Dmlamanon/drone-hardware/docs/tooling-preflight-2026-08-17c.md

---
type: preflight
status: current
created: 2026-08-17
tags: [stevie, tooling]
---

# Tooling pre-flight — 2026-08-17 (batch 4)

## Working

| Tool | Version | Notes |
|---|---|---|
| gcc (host) | 16.1.0 MinGW-W64 | native tests |
| arm-none-eabi-gcc | 14.2.Rel1 | `make cross`, `make firmware` |
| kicad-cli | 10.0.5 | DRC/ERC, gerbers, exports, `--schematic-parity` |
| KiCad MCP | responds | swig backend |
| FreeCAD | 1.1.3 | headless `freecadcmd.exe`, non-standard install path |
| Python (system) | 3.14.6 | analysis scripts |
| Java | OpenJDK 25.0.4 | Freerouting host |

## NEW THIS BATCH — headless `pcbnew` Python is available, and it is the item-3 route

Item 3 asks for a zone-fill path that is **not** the MCP's, because that
one shattered both planes (In1.Cu 2 → 19 filled polygons, In2.Cu 1 → 22).

**KiCad ships its own Python interpreter with the `pcbnew` module bound:**

```
C:\Program Files\KiCad\10.0\bin\python.exe
>>> import pcbnew; pcbnew.GetBuildVersion()   ->  '10.0.5'
>>> hasattr(pcbnew, 'ZONE_FILLER')            ->  True
>>> hasattr(pcbnew, 'LoadBoard')              ->  True
```

Verified this session by actually loading the real board, not just by
importing the module: 65 footprints, and the zones enumerate correctly.

This is a genuinely different code path from the MCP's — it is KiCad's
own in-tree filler, invoked through KiCad's own interpreter, rather than
whatever the MCP server wraps. Whether it produces the same fragmentation
is the open question item 3 exists to answer, and the answer is measured
rather than assumed.

## A counting correction that matters for item 3

Earlier batches said this board has **3 zones**. It has **2 copper
pours**. The third `(zone ...)` block in the file is a **keepout inside a
footprint** (F.Cu, carries `(keepout ...)`, no net, no fill), which is
why `pcbnew`'s `board.Zones()` returns 2 and a naive regex over the file
returns 3.

The fragment-count baseline for item 3 is therefore, from the
git-committed copper:

| pour | layer | filled polygons |
|---|---|---|
| `/GND` | In1.Cu | **2** |
| `/3V3` | In2.Cu | **1** |

Anything above those numbers after a refill is fragmentation, and the
comparison must use the *same* measurement on both sides — the last batch
established that the hard way, when a "281 violations" baseline turned
out to be an artifact of running DRC on a board extracted without its
`.kicad_pro`.

## Ground station (item 7)

`engineering/drone-firmware/tools/ground-station/` exists with `gs.py`,
`telemetry_frame.py`, `params_cli.py`, `plot_session.py` and
`test_decoder.py`.

**Confirmed working this session by running it, not by noting it exists:**
the cross-validation that keeps the Python decoder byte-identical to the C
encoder is `tools/ground-station/test_decoder.py`. It compiles the real
`src/telemetry.c`, has it encode, and decodes in Python. Currently passing,
including the check `python encode() is byte-identical to C's`.

**It lives outside `test/`, so `make test` does not run it.** Item 7
requires extending it for any frame change, which means invoking it
explicitly (`python test_decoder.py` from that directory) in addition to
`make test`. If it ever reports "SKIPPED: no C compiler", the
cross-validation did not actually happen and the run proves nothing.

## Item 1's inputs both exist

- Board mounting holes: `MH1`–`MH4` in `bench_board.kicad_pcb`.
- Frame pattern: `FC_MOUNT = 30.5` in
  `mechanical/frame-v0/frame_v0.py`, and the exported
  `stevie-frame-v0-flats-petg.dxf`.

Item 1 requires extracting **both** from the actual files and asserting
they match — so the DXF must be parsed, not the script's constant read.
DXF export is confirmed working (97 KB written last batch).

## Carried forward

- **Freerouting 2.3.0** will not honour `(type power)` layer reservation
  and hung 16 minutes when forced. Unchanged.
- **FreeCAD rejects MSYS-style paths.** Every export path must be a
  native Windows path.
- **Do not use the MCP `refill_zones`.** Documented failure, item 3 says
  so explicitly.
- **`delete_trace` with both `net` and `position`** ignores the position
  and bulk-deletes the whole net. Pass one or the other.
- **`sync_schematic_to_board` strips the leading `/` from net names**,
  which disables this board's Power netclass. Re-check after any sync.

---

## BLOCKING-DIALOG HAZARD in headless pcbnew — found and fixed mid-batch

**`PCB_VIA::GetWidth()` and `SetWidth()` trip a wxWidgets debug assert on
KiCad 10** — *"called without a layer argument"*. Interactively that is a
modal dialog. **In an unattended batch it is a stall that waits forever
for a click nobody is there to give**, and the run looks hung rather than
broken. That is the failure mode that matters here: this batch runs with
nobody watching.

It fired from `scripts/viasite.py` while searching for a via site.

### The fix, in two layers

`scripts/kicad_safe.py` is now the shared preamble for **every** headless
pcbnew script in this repo, and it does both halves:

1. **`wx.DisableAsserts()` on import**, before any board is touched, so no
   script can forget it and no *future* assert of this class can stall a
   run either. Verified active (`asserts_disabled() -> True`) and the
   assert output is now zero lines where it was ten.
2. **Correct accessors**, because suppressing a dialog is not the same as
   calling the API right. KiCad 10 exposes layer-free
   `GetFrontWidth()` / `SetFrontWidth()`; `via_width()` and
   `set_via_width()` wrap them. Every via on this board is a plain
   through via, so front width *is* the width.

### Audit of every pcbnew call site in the repo

Done by grep rather than by memory, because the point is that none are
left:

| file | risky call | status |
|---|---|---|
| `viasite.py` | `GetWidth()` on a via | **was the one that fired** — now `via_width()` |
| `mh3_rework.py` | `SetWidth()` on a new via | now `set_via_width()` |
| `repath.py` | `GetWidth()`/`SetWidth()` | on `PCB_TRACK` only (guarded by an earlier `if via: continue`) — safe |
| `patternsearch.py` | `GetWidth()` | in the non-via branch — safe; `GetDrill()` on vias takes no layer and does not assert |
| `courtyards.py`, `fitpart.py`, `check_fc_pattern.py` | — | no via geometry |

**Standing rule for this project: any script that runs unattended imports
`kicad_safe` first.** A blocking dialog in a batch is not a nuisance, it
is an unbounded hang.

---

## Zone fill: the pcbnew route WORKS, and the MCP route still must not be used

Item 3 asked whether headless `pcbnew`'s `ZONE_FILLER` fragments the
planes the way the MCP's refill did. **It does not.**

Measured the same way on both sides — filled-polygon count read out of the
board file, which is the discipline that was missing when a "281
violations" baseline turned out to be a probe artifact:

| pour | git-stored | MCP refill (last batch) | **pcbnew ZONE_FILLER** |
|---|---|---|---|
| `/GND` on In1.Cu | 2 polygons | **19** | **2** |
| `/3V3` on In2.Cu | 1 polygon | **22** | **1** |

Coverage is unchanged too: 3291.2 → 3296.6 mm² on In1.Cu and
3089.6 → 3092.2 mm² on In2.Cu, the small increase being the new antipads
around the moved mounting holes and the new vias. So the fill is not just
un-fragmented, it is the *same plane*.

**And it fixed more than it was asked to.** DRC went **64 → 54**, which is
below the batch's starting baseline: every zone-related `clearance` and
`hole_clearance` violation cleared, including six that predate this batch.

`scripts/refill_zones.py` does the fill and prints the fragment count
before and after, so the question "did this shatter the planes" is
answered with a number rather than a hope. It exits non-zero if any pour
gains more than two polygons.

**The MCP `refill_zones` is still banned.** Nothing here rehabilitates it;
it shattered the planes on this same board and the ban stands.

### Why polygon count alone is not the proof — and what is

A reasonable objection to the table above: **a plane can be badly
fragmented while keeping the same filled-polygon count.** One polygon with
a huge void through the middle, joined by a thread of copper, counts as
one. So the count is necessary and not sufficient, and this is the exact
shape of error this project has made before.

Three independent measurements were taken, and the conclusion rests on
all three:

1. **Polygon count** — 2 and 1, matching the git-stored copper.
2. **Coverage area** — 3291.2 → 3296.6 mm² and 3089.6 → 3092.2 mm². A
   plane hollowed out by a void would lose area; these gained a little,
   which is the new antipads.
3. **`isolated_copper` from DRC — zero.** This is the one that actually
   speaks to connectivity: KiCad reports a fill island that connects to
   nothing on its net. The MCP's shattered fill produced **41** of these.
   The pcbnew fill produces **none**, and `via_dangling` is also **0**.

Point 3 is the load-bearing one. If a future refill keeps the count and
the area but splits a plane, `isolated_copper` is what will say so —
`scripts/refill_zones.py` checks the count, and **DRC has to be run
afterwards regardless.**
