Dmlamanon/drone-hardware/mechanical/frame-v0/stevie-frame-v0-petg.step

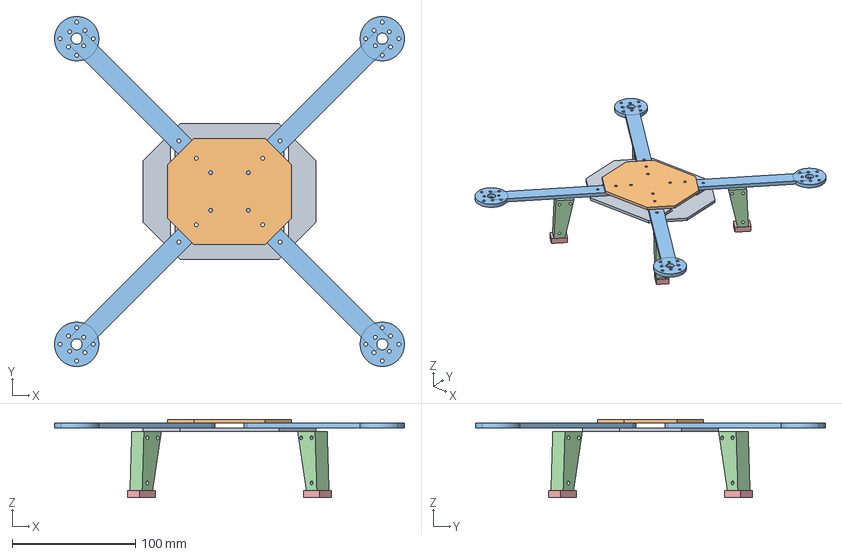
[picture p1: CAD file, 2026-08-18]
mechanical/frame-v0/stevie-frame-v0-petg.step
283.4 x 283.4 x 63.5 mm
bottom_plate
top_plate
arm_1
arm_2
arm_3
arm_4
leg_1
leg_2
leg_3
leg_4
foot_1
foot_2
foot_3
foot_4
