Dmlamanon/drone-hardware/mechanical/frame-v0/part-foot-1-petg.stl

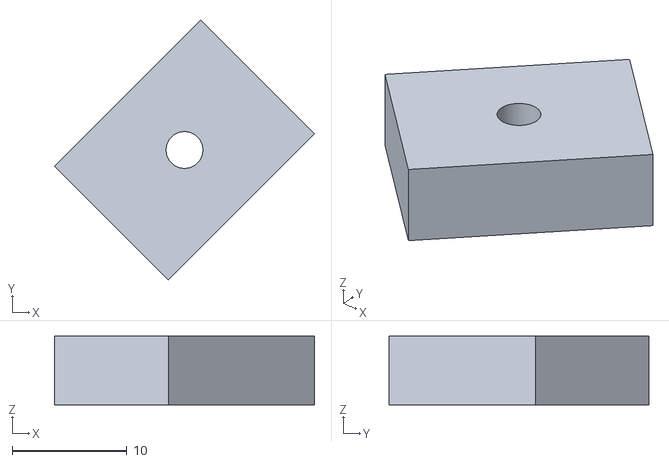
[picture p3: CAD file, 2026-08-17]
mechanical/frame-v0/part-foot-1-petg.stl
22.6 x 22.6 x 6.00
