Dmlamanon/drone-hardware/mechanical/frame-v0/part-leg-1-petg.stl

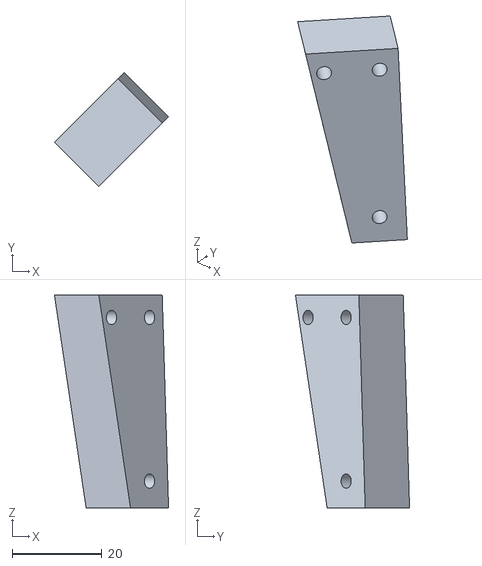
[picture p4: CAD file, 2026-08-17]
mechanical/frame-v0/part-leg-1-petg.stl
25.5 x 25.5 x 47.5
