Dmlamanon/drone-hardware/mechanical/frame-v0/stevie-frame-v0-flats-cf.dxf

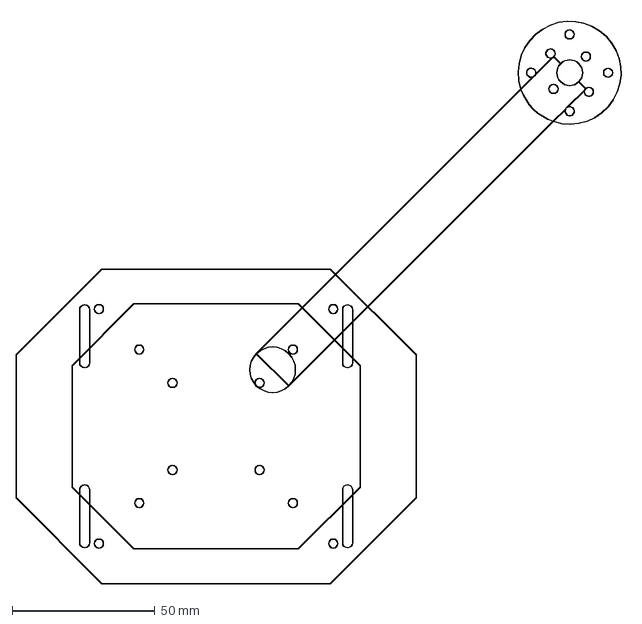
[picture p5: CAD file, 2026-08-17]
mechanical/frame-v0/stevie-frame-v0-flats-cf.dxf
213.4 x 198.4 mm
