Dmlamanon/drone-hardware/mechanical/frame-v0/stevie-frame-v0-flats-petg.dxf

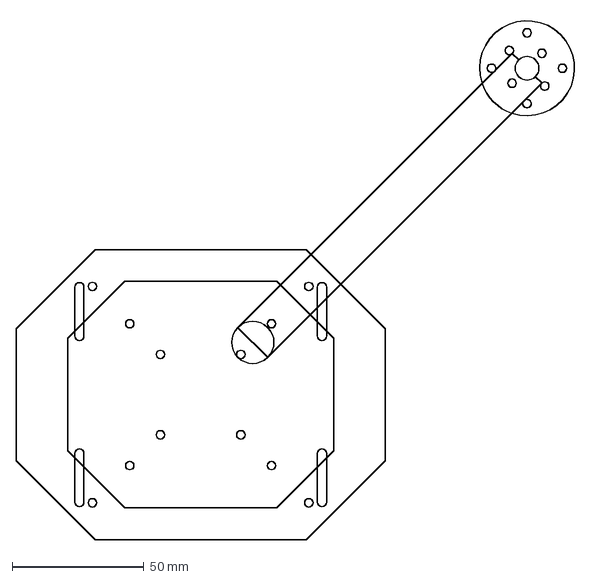
[picture p6: CAD file, 2026-08-17]
mechanical/frame-v0/stevie-frame-v0-flats-petg.dxf
213.4 x 198.4 mm
