Dmlamanon/drone-hardware/mechanical/frame-v0/part-bottom-plate-cf.stl

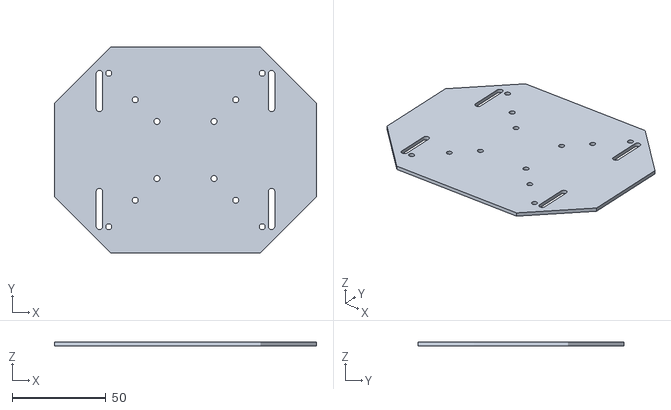
[picture p7: CAD file, 2026-08-17]
mechanical/frame-v0/part-bottom-plate-cf.stl
140.0 x 110.0 x 2.00
