Dmlamanon/drone-hardware/mechanical/frame-v0/part-bottom-plate-petg.stl

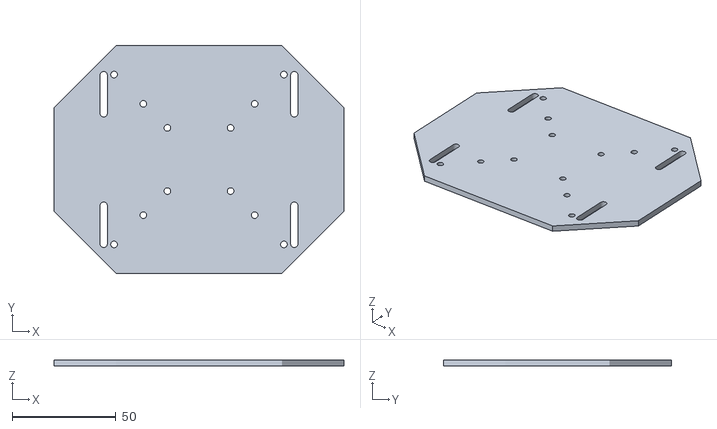
[picture p8: CAD file, 2026-08-17]
mechanical/frame-v0/part-bottom-plate-petg.stl
140.0 x 110.0 x 3.00
