Dmlamanon/drone-hardware/mechanical/frame-v0/part-arm-1-petg.stl

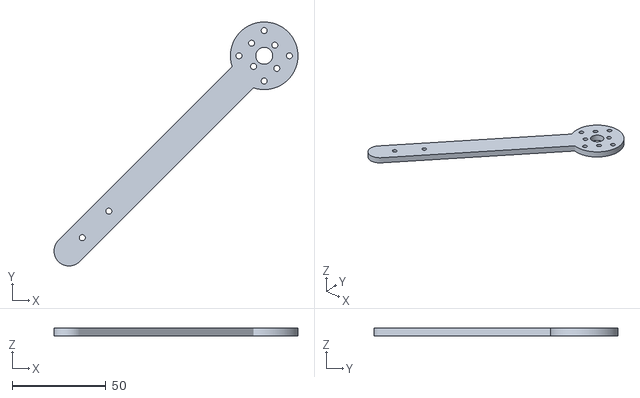
[picture p9: CAD file, 2026-08-17]
mechanical/frame-v0/part-arm-1-petg.stl
129.9 x 129.9 x 4.00
