Dmlamanon/drone-hardware/mechanical/frame-v0/part-arm-1-cf.stl

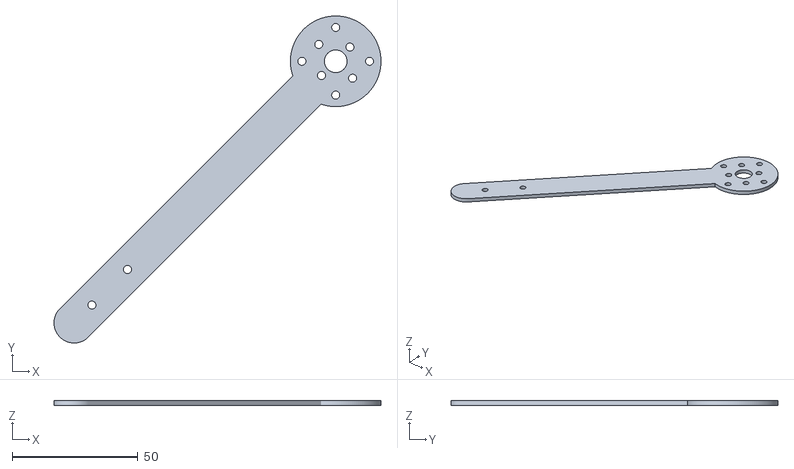
[picture p10: CAD file, 2026-08-17]
mechanical/frame-v0/part-arm-1-cf.stl
129.9 x 129.9 x 2.00
