Dmlamanon/drone-hardware/mechanical/frame-v0/part-top-plate-cf.stl

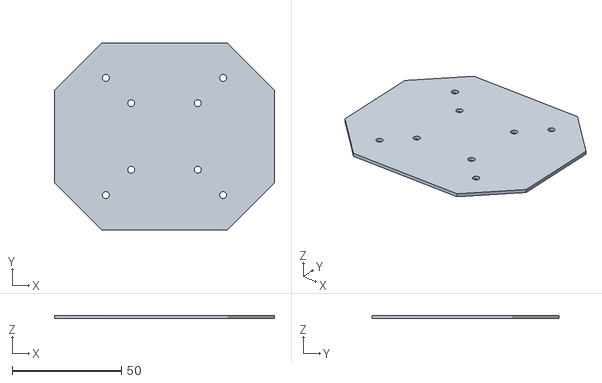
[picture p11: CAD file, 2026-08-17]
mechanical/frame-v0/part-top-plate-cf.stl
100.8 x 85.8 x 1.50
