Dmlamanon/drone-hardware/mechanical/frame-v0/part-top-plate-petg.stl

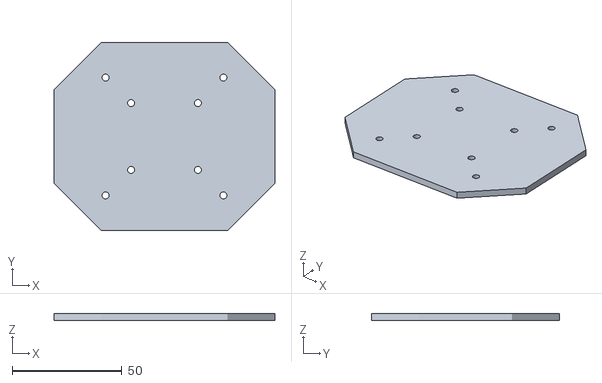
[picture p12: CAD file, 2026-08-17]
mechanical/frame-v0/part-top-plate-petg.stl
100.8 x 85.8 x 3.00
