Dmlamanon/drone-hardware/(list of files, cad)

Other CAD files:
mechanical/frame-v0/stevie-frame-v0-cf.stl
mechanical/frame-v0/stevie-frame-v0-petg.stl
