Dmlamanon/drone-hardware/mechanical/frame-v0/build-report-petg.txt

====================================================================
STEVIE frame v0 -- PETG variant
====================================================================
wheelbase (motor-motor diagonal) : 350.0 mm
adjacent motor spacing           : 247.49 mm  (= wheelbase / sqrt(2))
prop diameter                    : 228.6 mm
PROP TIP GAP                     : 18.89 mm  = 8.26 % of prop dia

The >=10 % rule needs one of:
  prop <= 225.0 mm (8.86 in) at this wheelbase, or
  wheelbase >= 355.6 mm with this prop

Frame geometry CANNOT improve this at a fixed wheelbase, and that is
worth stating as a derivation rather than an opinion:
  four motors sit on a circle of radius wheelbase/2. Adjacent tip gap
  is set by the SMALLEST adjacent chord. For a rectangle of half-width
  a and half-length b with 2*sqrt(a^2+b^2) = wheelbase, the adjacent
  spacings are 2a and 2b, so min(2a, 2b) is maximised at a = b --
  i.e. by the symmetric X this frame already is. A stretched or
  'dead-cat' layout makes one pair CLOSER, never further apart.
  Longer arms do not help either: they would increase the wheelbase,
  which is the fixed input.

arm length (root r=28 to pad edge) : 165.0 mm
plate 140 x 110 x 3.0 mm, arms 16 x 4.0 mm

bottom plate: 16 holes/slots cut, volume 39618 mm^3
top plate:    8 holes cut, volume 22954 mm^3
arm:          volume 12193 mm^3, 165.0 mm long
leg:          volume 10302 mm^3, 48 mm tall
foot:         volume 1464 mm^3 (the crash consumable)

geometry checks:
  every hole and slot is inside the plate OUTLINE, not just its bbox OK   all 28 clear
  battery bay fits within the plate long axis          OK   135.0 <= 140.0
  FC mount pattern clears the battery straps           OK   18.45 < 20.50 mm
  props do not overlap                                 OK   18.89 mm gap

PROP CLEARANCE: 8.26 % -- ACCEPTED 2026-08-17, not a failure.
  Precedent: the DJI Phantom 3 ships 9.4 in props on this same 350 mm
  class. Its adjacent spacing is the same 247.49 mm, so its tip gap is
  247.49 - 238.76 = 8.73 mm = 3.7 % of prop diameter -- less than HALF
  this frame's 8.3 %, on a flight-proven airframe built at scale.
  The >=10 % figure is a noise-and-efficiency guideline, not a limit.

  arm thickness meets the PETG minimum                 OK   4.0 mm
  plate thickness meets the PETG minimum               OK   3.0 mm
  motor pad clears the 16x19 cross                     OK   36.0 > 25.4
  motor pad clears the 19x19 square (the chosen X2814) OK   pad r 18.0 > 16.6
  the two patterns' holes do not merge into each other OK   9.62 mm apart
  arm root starts inside the plate                     OK   28.0 < 55.0
  the landing gear clears the slung battery            OK   53.5 mm ground clearance vs a 35.5 mm pack drop (18.0 mm of air, 12.0 required)
  the legs sit inboard of the motors                   OK   web reaches r=107.0, foot reaches r=110.0, motor at r=175.0
  the legs mount on the arm, not off the end of it     OK   top land spans r=85.0..105.0, arm spans 28.0..175.0
  the gear is not tippy (static tip-over angle)        OK   55.5 deg about the axis between two adjacent feet (>= 25 required)
  leg web thickness meets the printed-part minimum     OK   14.0 mm (printed in both builds -- see SHEET_PARTS)
  the landing gear is printed, not cut from the sheet  OK   sheet: bottom_plate, top_plate, arm_1 | printed: leg_1, foot_1
  symmetric X maximises the minimum adjacent spacing   OK   247.49 vs best stretched-X 247.49 mm

mass estimate (PETG sheet parts, rho = 1.27 g/cm^3;
               printed gear, rho = 1.27 g/cm^3):
  bottom plate        50.3 g
  top plate           29.2 g
  arms (x4)           61.9 g
  legs (x4)           52.3 g  (printed)
  feet (x4)            7.4 g  (printed)
  ---------------------------
  structure          201.2 g

  The AUW budget carries 469 g for 'frame'. This is STRUCTURE ONLY --
  Landing gear IS included from v0.1. Still missing: standoffs,
  fasteners, canopy and battery tray -- real mass, not modelled, so do
  NOT read 201 g as beating the budget.

SVG   -> D:\claude-obsidian\engineering\drone-hardware\mechanical\frame-v0\stevie-frame-v0-petg-plan.svg

STEP  -> D:\claude-obsidian\engineering\drone-hardware\mechanical\frame-v0\stevie-frame-v0-petg.step
STL   -> D:\claude-obsidian\engineering\drone-hardware\mechanical\frame-v0\stevie-frame-v0-petg.stl
STL   -> D:\claude-obsidian\engineering\drone-hardware\mechanical\frame-v0\part-bottom-plate-petg.stl
STL   -> D:\claude-obsidian\engineering\drone-hardware\mechanical\frame-v0\part-top-plate-petg.stl
STL   -> D:\claude-obsidian\engineering\drone-hardware\mechanical\frame-v0\part-arm-1-petg.stl
STL   -> D:\claude-obsidian\engineering\drone-hardware\mechanical\frame-v0\part-leg-1-petg.stl
STL   -> D:\claude-obsidian\engineering\drone-hardware\mechanical\frame-v0\part-foot-1-petg.stl
DXF   -> D:\claude-obsidian\engineering\drone-hardware\mechanical\frame-v0\stevie-frame-v0-flats-petg.dxf

RESULT: all geometry checks passed
