Dmlamanon/drone-hardware/(list of files, drawings)

Other design files:
bench_board/bench_board.dsn
bench_board/bench_board_constrained.dsn
