Dmlamanon/drone-hardware/bench_board/bench_board.kicad_pcb

## KiCad design bench_board/bench_board.kicad_pcb (2026-08-18)

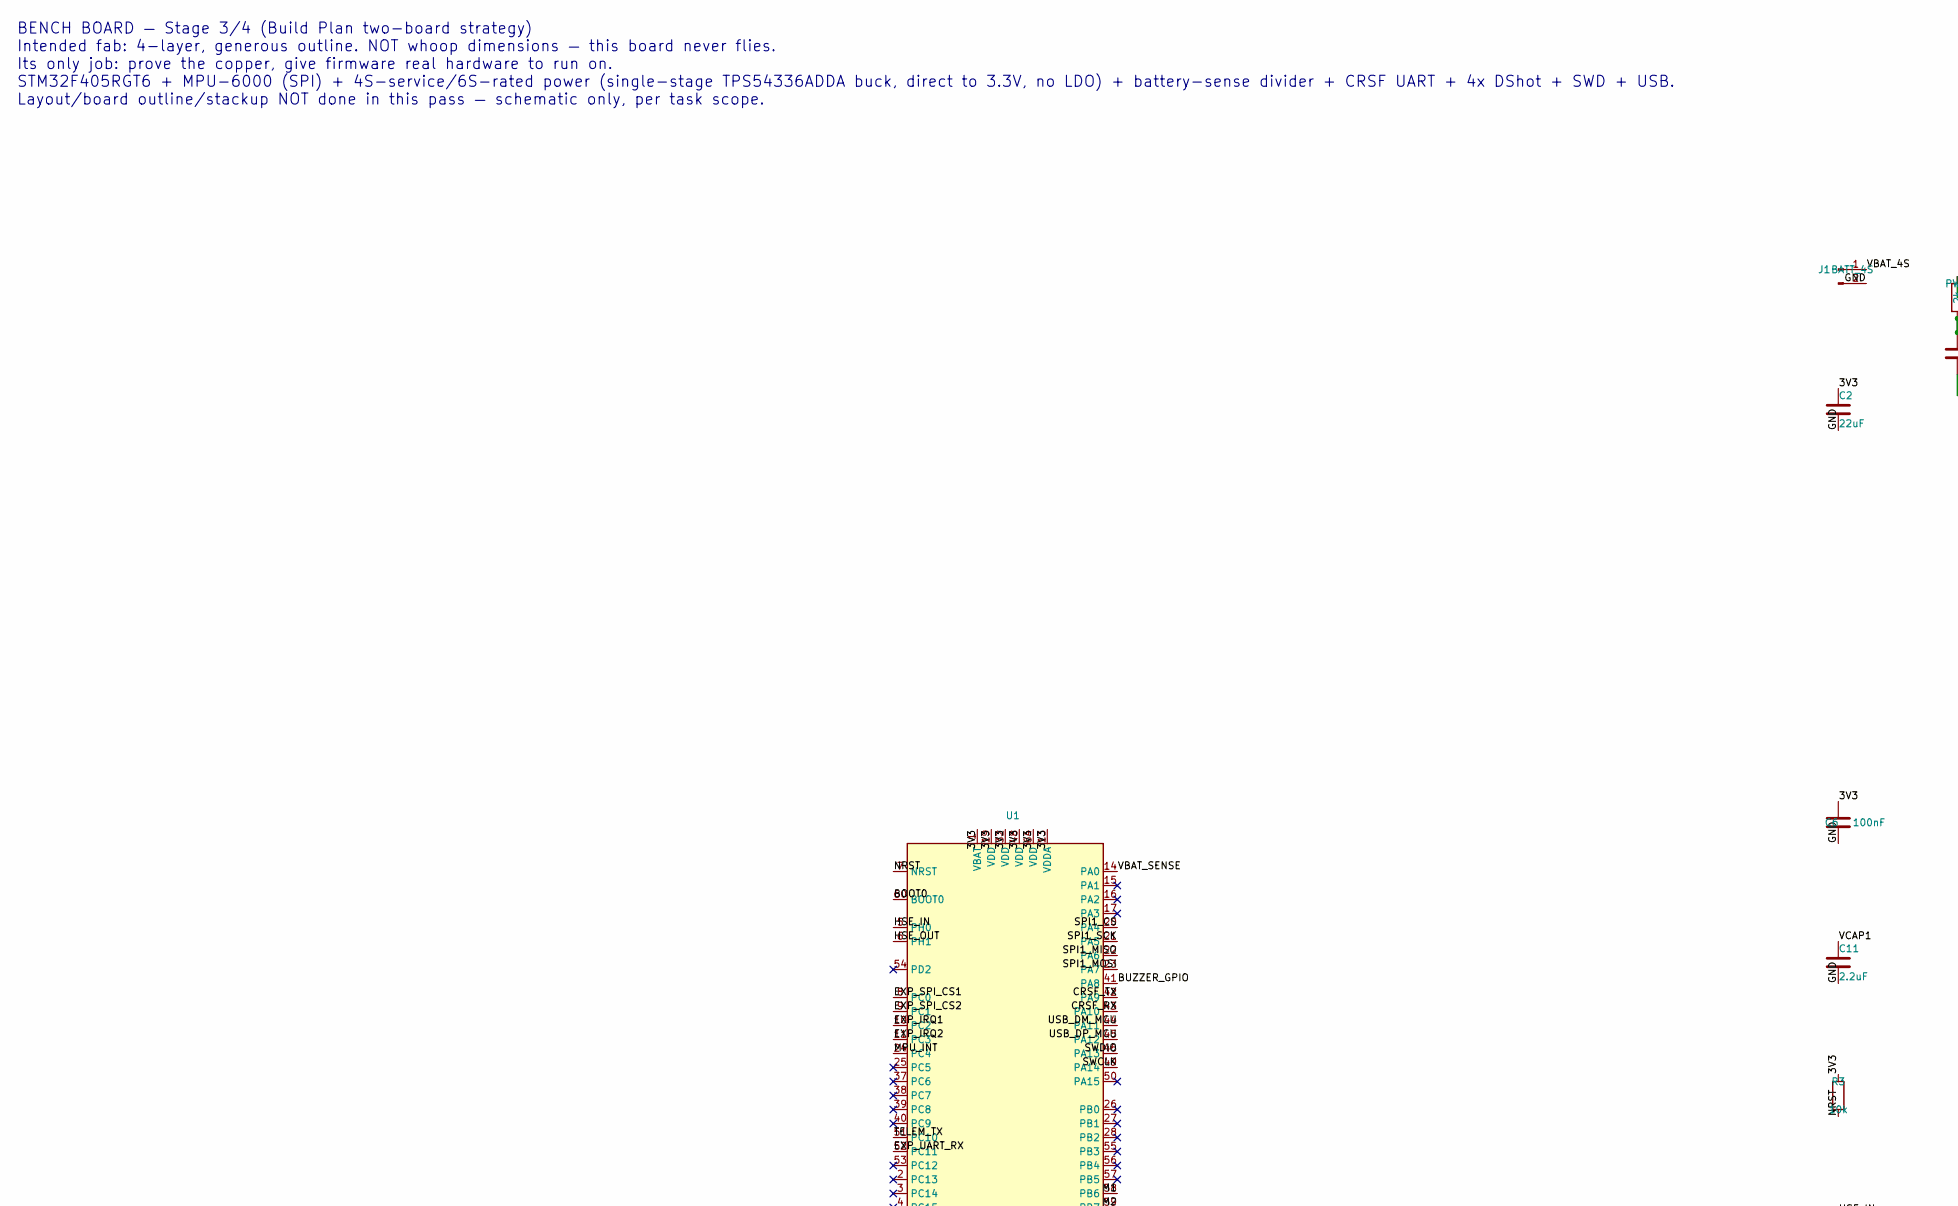
[picture p13: schematic bench_board.kicad_sch, part in row 1, column 1]

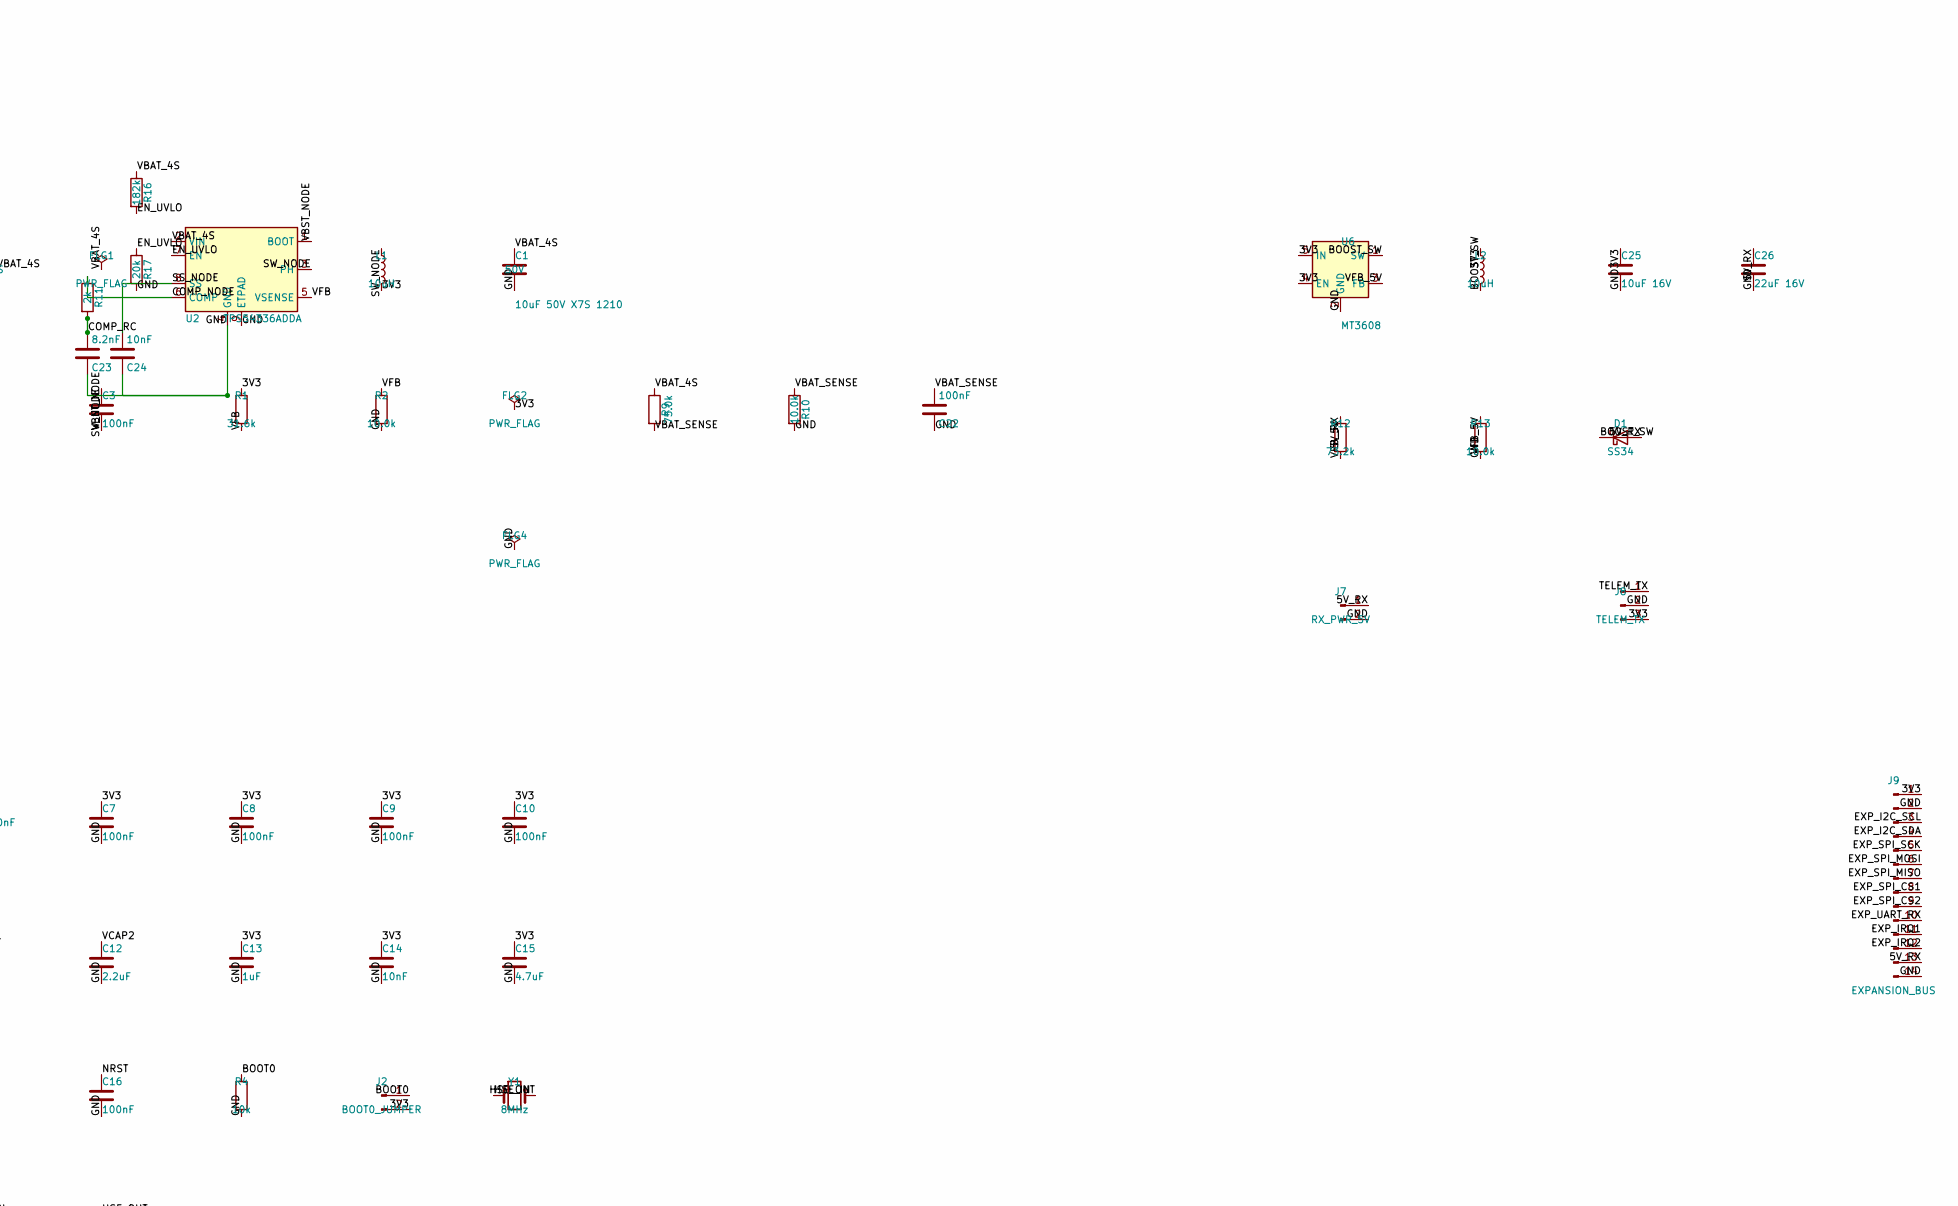
[picture p14: schematic bench_board.kicad_sch, part in row 1, column 2]

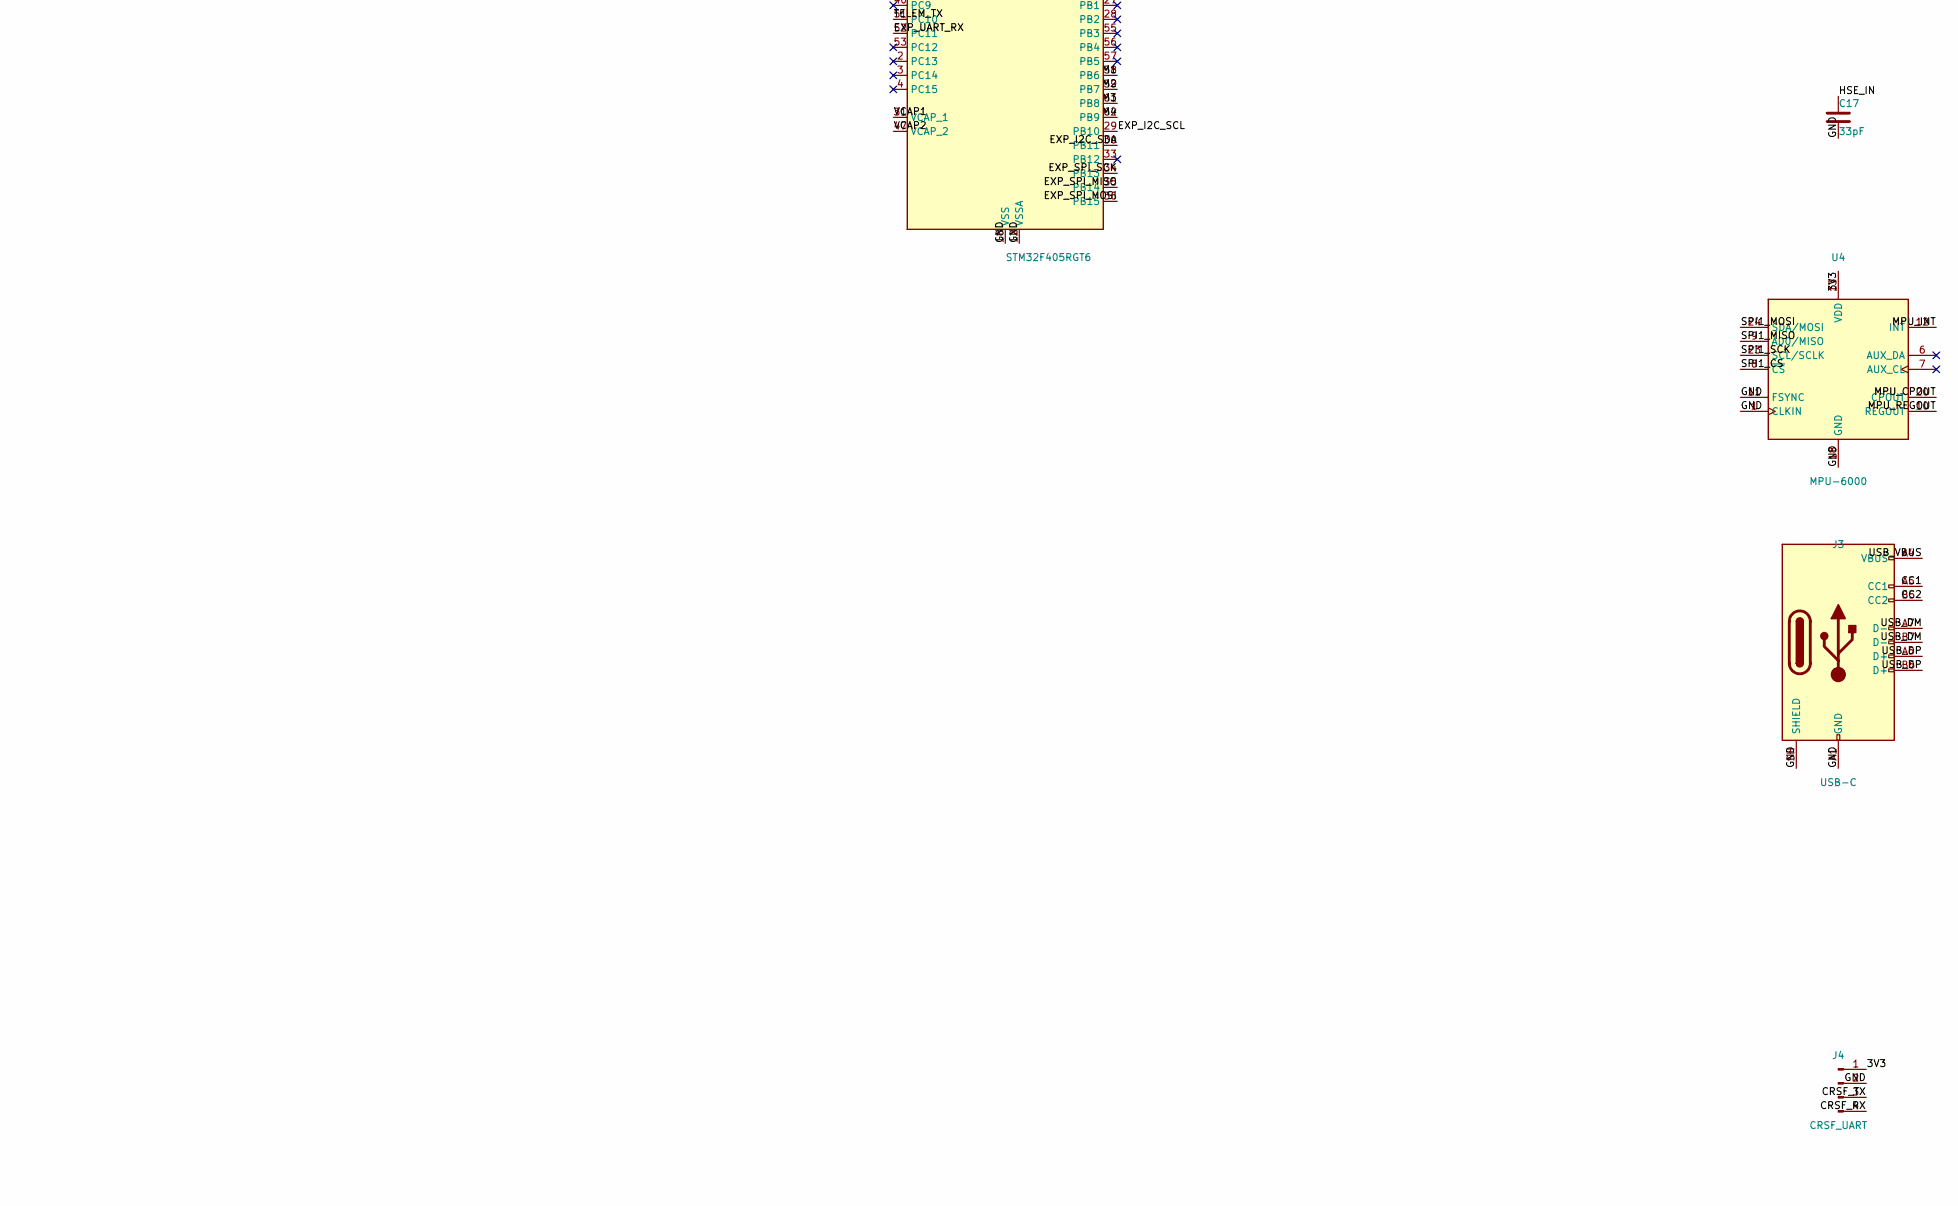
[picture p15: schematic bench_board.kicad_sch, part in row 2, column 1]

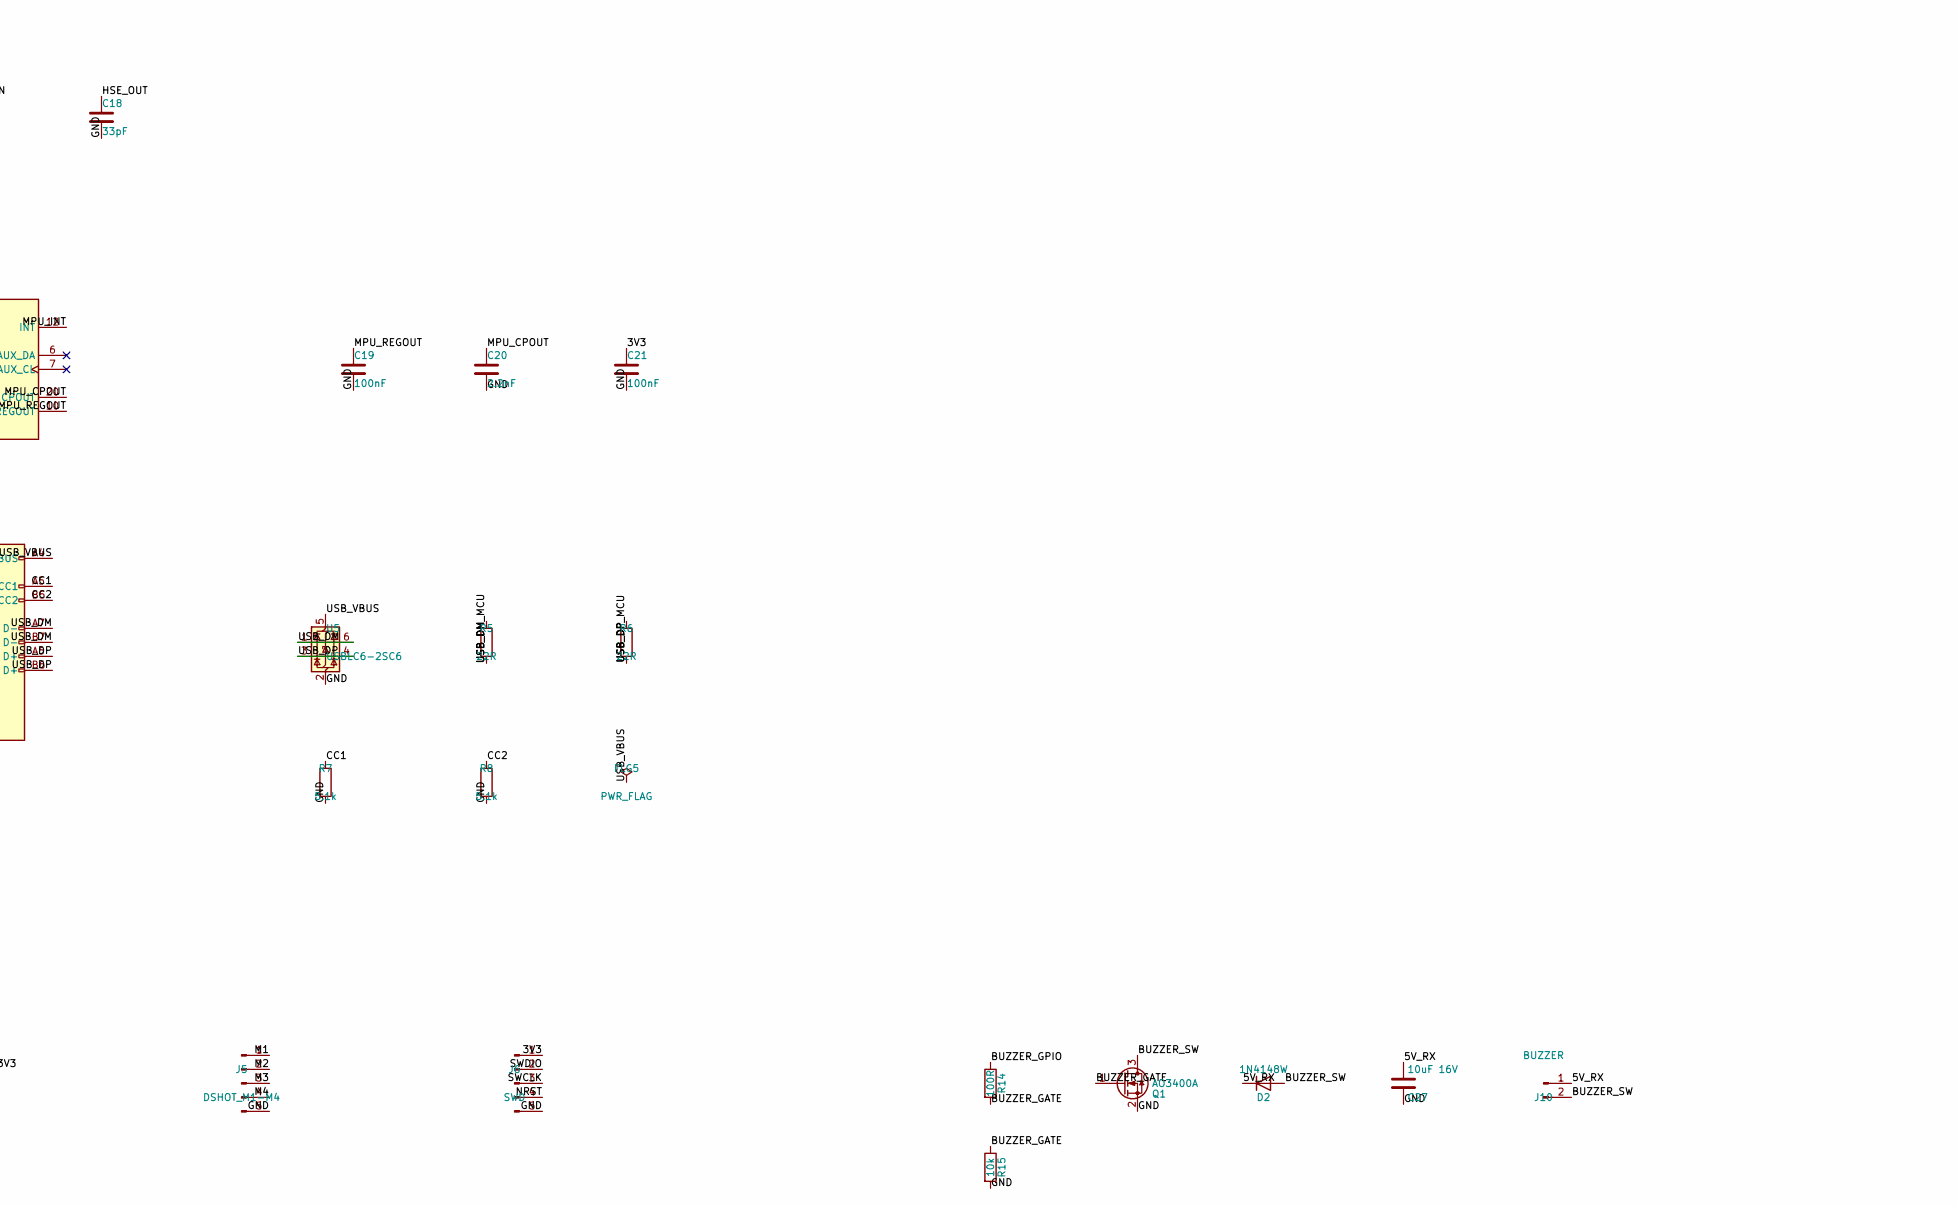
[picture p16: schematic bench_board.kicad_sch, part in row 2, column 2]

Parts:
C1: 10uF 50V X7S 1210; C_1210_3225Metric; Voltage 50V; MPN GRM32ER71H106KA12L
C2: 22uF; C_0805_2012Metric
C3, C6, C7, C8, C9, C10, C16, C19, C21, C22: 100nF; C_0402_1005Metric
C11, C12: 2.2uF; C_0603_1608Metric
C13: 1uF; C_0603_1608Metric
C14, C24: 10nF; C_0402_1005Metric
C15: 4.7uF; C_0805_2012Metric
C17, C18: 33pF; C_0402_1005Metric
C20: 2.2nF; C_0402_1005Metric
C23: 8.2nF; C_0402_1005Metric
C25, C27: 10uF 16V; C_0805_2012Metric
C26: 22uF 16V; C_0805_2012Metric
D1: SS34; D_SMA
D2: 1N4148W; D_SOD-123
FLG1, FLG2, FLG4, FLG5: PWR_FLAG
J1: BATT_4S; PinHeader_1x02_P2.54mm_Vertical
J2: BOOT0_JUMPER; PinHeader_1x02_P2.54mm_Vertical
J3: USB-C; USB_C_Receptacle_Amphenol_12401548E4-2A
J4: CRSF_UART; PinHeader_1x04_P2.54mm_Vertical
J5: DSHOT_M1-M4; PinHeader_1x05_P2.54mm_Vertical
J6: SWD; PinHeader_1x05_P2.54mm_Vertical
J7: RX_PWR_5V; PinHeader_1x02_P2.54mm_Vertical
J8: TELEM_TX; PinHeader_1x03_P2.54mm_Vertical
J9: EXPANSION_BUS; PinHeader_1x14_P2.54mm_Vertical
J10: BUZZER; PinHeader_1x02_P2.54mm_Vertical
L1, L2: 10uH; L_1210_3225Metric
Q1: AO3400A; SOT-23
R1: 31.6k; R_0402_1005Metric
R2, R10: 10.0k; R_0402_1005Metric
R3, R4, R15: 10k; R_0402_1005Metric
R5, R6: 22R; R_0402_1005Metric
R7, R8: 5.1k; R_0402_1005Metric
R9: 75.0k; R_0402_1005Metric
R11: 2k; R_0402_1005Metric
R12: 73.2k; R_0603_1608Metric
R13: 10.0k; R_0603_1608Metric
R14: 100R; R_0402_1005Metric
R16: 182k; R_0402_1005Metric
R17: 20k; R_0402_1005Metric
U1: STM32F405RGT6; LQFP-64_10x10mm_P0.5mm
U2: TPS54336ADDA; SOIC-8-1EP_3.9x4.9mm_P1.27mm_EP2.41x3.81mm
U4: MPU-6000; InvenSense_QFN-24_4x4mm_P0.5mm
U5: USBLC6-2SC6; SOT-23-6
U6: MT3608; SOT-23-6
Y1: 8MHz; Crystal_SMD_5032-2Pin_5.0x3.2mm; LCSC C115962

Connections:
/3V3: C2.1, C6.1, C7.1, C8.1, C9.1, C10.1, C13.1, C14.1, C15.1, C21.1, C25.1, FLG2.1, J2.2, J4.1, J6.1, J8.3, J9.1, L1.2, L2.1, R1.1, R3.1, U1.1 (VBAT), U1.13 (VDDA), U1.19 (VDD), U1.32 (VDD), U1.48 (VDD), U1.64 (VDD), U4.13 (VDD), U6.4 (EN), U6.5 (IN)
/5V_RX: C26.1, C27.1, D1.2 (A), D2.1 (K), J7.1, J9.13, J10.1, R12.1
/BOOST_SW: D1.1 (K), L2.2, U6.1 (SW)
/BOOT0: J2.1, R4.1, U1.60 (BOOT0)
/BUZZER_GATE: Q1.1 (G), R14.2, R15.1
/BUZZER_GPIO: R14.1, U1.41 (PA8)
/BUZZER_SW: D2.2 (A), J10.2, Q1.3 (D)
/CC1: J3.A5 (CC1), R7.1
/CC2: J3.B5 (CC2), R8.1
/COMP_NODE: R11.1, U2.6 (COMP)
/COMP_RC: C23.1, R11.2
/CRSF_RX: J4.4, U1.43 (PA10)
/CRSF_TX: J4.3, U1.42 (PA9)
/EN_UVLO: R16.2, R17.1, U2.7 (EN)
/EXP_I2C_SCL: J9.3, U1.29 (PB10)
/EXP_I2C_SDA: J9.4, U1.30 (PB11)
/EXP_IRQ1: J9.11, U1.10 (PC2)
/EXP_IRQ2: J9.12, U1.11 (PC3)
/EXP_SPI_CS1: J9.8, U1.8 (PC0)
/EXP_SPI_CS2: J9.9, U1.9 (PC1)
/EXP_SPI_MISO: J9.7, U1.35 (PB14)
/EXP_SPI_MOSI: J9.6, U1.36 (PB15)
/EXP_SPI_SCK: J9.5, U1.34 (PB13)
/EXP_UART_RX: J9.10, U1.52 (PC11)
/GND: C1.2, C2.2, C6.2, C7.2, C8.2, C9.2, C10.2, C11.2, C12.2, C13.2, C14.2, C15.2, C16.2, C17.2, C18.2, C19.2, C20.2, C21.2, C22.2, C23.2, C24.2, C25.2, C26.2, C27.2, FLG4.1, J1.2, J3.A1 (GND), J3.A12 (GND), J3.B1 (GND), J3.B12 (GND), J3.SH (SHIELD), J4.2, J5.5, J6.5, J7.2, J8.2, J9.2, J9.14, Q1.2 (S), R2.2, R4.2, R7.2, R8.2, R10.2, R13.2, R15.2, R17.2, U1.12 (VSSA), U1.18 (VSS), U1.63 (VSS), U2.4 (GND), U2.9 (ETPAD), U4.1 (CLKIN), U4.11 (FSYNC), U4.18 (GND), U5.2 (GND), U6.2 (GND)
/HSE_IN: C17.1, U1.5 (PH0), Y1.1
/HSE_OUT: C18.1, U1.6 (PH1), Y1.2
/M1: J5.1, U1.58 (PB6)
/M2: J5.2, U1.59 (PB7)
/M3: J5.3, U1.61 (PB8)
/M4: J5.4, U1.62 (PB9)
/MPU_CPOUT: C20.1, U4.20 (CPOUT)
/MPU_INT: U1.24 (PC4), U4.12 (INT)
/MPU_REGOUT: C19.1, U4.10 (REGOUT)
/NRST: C16.1, J6.4, R3.2, U1.7 (NRST)
/SPI1_CS: U1.20 (PA4), U4.8 (~CS)
/SPI1_MISO: U1.22 (PA6), U4.9 (AD0/MISO)
/SPI1_MOSI: U1.23 (PA7), U4.24 (SDA/MOSI)
/SPI1_SCK: U1.21 (PA5), U4.23 (SCL/SCLK)
/SS_NODE: C24.1, U2.8 (SS)
/SWCLK: J6.3, U1.49 (PA14)
/SWDIO: J6.2, U1.46 (PA13)
/SW_NODE: C3.1, L1.1, U2.3 (PH)
/TELEM_TX: J8.1, U1.51 (PC10)
/USB_DM: J3.A7 (D-), J3.B7 (D-), R5.1, U5.1 (I/O1), U5.6 (I/O1)
/USB_DM_MCU: R5.2, U1.44 (PA11)
/USB_DP: J3.A6 (D+), J3.B6 (D+), R6.1, U5.3 (I/O2), U5.4 (I/O2)
/USB_DP_MCU: R6.2, U1.45 (PA12)
/USB_VBUS: FLG5.1, J3.A4 (VBUS), J3.A9 (VBUS), J3.B4 (VBUS), J3.B9 (VBUS), U5.5 (VBUS)
/VBAT_4S: C1.1, FLG1.1, J1.1, R9.1, R16.1, U2.2 (VIN)
/VBAT_SENSE: C22.1, R9.2, R10.1, U1.14 (PA0)
/VBST_NODE: C3.2, U2.1 (BOOT)
/VCAP1: C11.1, U1.31 (VCAP_1)
/VCAP2: C12.1, U1.47 (VCAP_2)
/VFB: R1.2, R2.1, U2.5 (VSENSE)
/VFB_5V: R12.2, R13.1, U6.3 (FB)

Notes on the sheet:
BENCH BOARD — Stage 3/4 (Build Plan two-board strategy) Intended fab: 4-layer, generous outline. NOT whoop dimensions — this board never flies. Its only job: prove the copper, give firmware real hardware to run on. STM32F405RGT6 + MPU-6000 (SPI) + 4S-service/6S-rated power (single-stage TPS54336ADD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

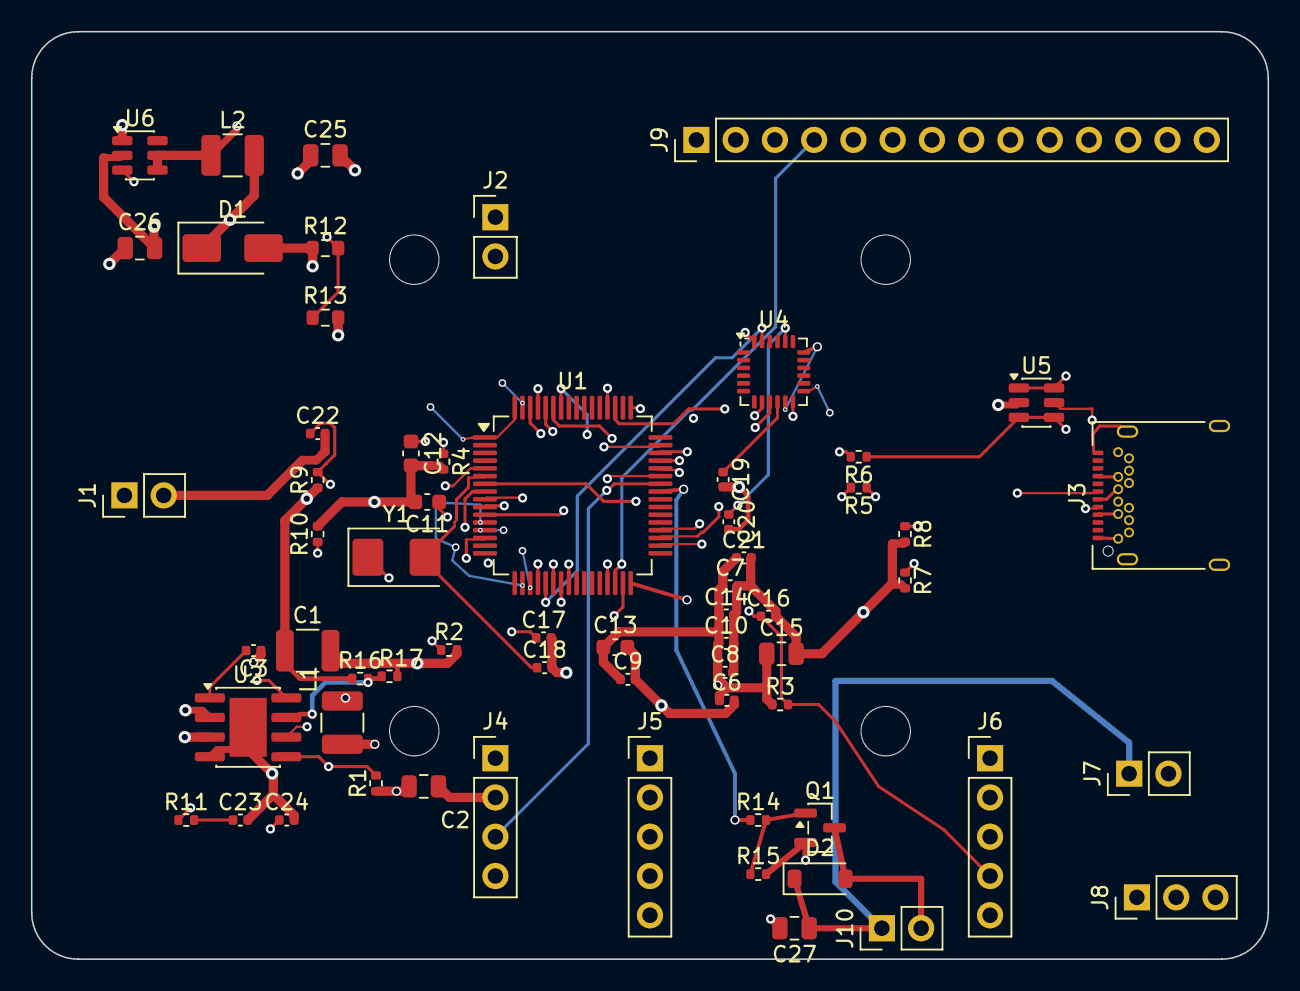
[picture p17: board bench_board.kicad_pcb from above]

Board: 4 copper layers, 80.0 x 60.0 mm, 67 parts (0 on the bottom side), 56 nets.

Other parts of the board:
MH1, MH2, MH3, MH4: MountingHole_3.2mm; MountingHole_3.2mm_M3
