Dmlamanon/drone-hardware/(commit log)

2026-08-16 Initial commit: bench board schematic (ERC clean)
    STM32F405RGT6 + MPU-6000 SPI + 2S power (buck->5V, LDO->3.3V) + CRSF
    UART + 4x DShot + SWD + USB, full bring-up circuit. 47 components,
    0 ERC errors/warnings. Schematic only, no layout yet.
    This repo had no version control until now -- first commit captures
    current state as the baseline.
    [bench_board.kicad_pcb, bench_board.kicad_sch]
2026-08-16 Power path analysis (SPICE blocked -- hand calculation instead, documented)
    ngspice isn't installed (no CLI, no winget package) and KiCad's bundled
    ngspice.dll is GUI-only (Eeschema's Simulate tab, no MCP/CLI path to
    drive it). Neither TPS563201 nor AMS1117-3.3 has a real SPICE model in
    KiCad's bundled symbol libraries either (grep -ic spice returns 0 on
    both). Documented both blockers rather than faking a simulation result.
    Did a hand-calculation analysis instead, against real datasheet
    parameters (TI product page for TPS563201, AMS datasheet for
    AMS1117-3.3), covering the same questions:
    Two real findings:
    - Buck duty-cycle margin fails at the low end of the board's own stated
    6.0-8.4V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
2026-08-16 Cross-check power design against known micro-FC failure modes
    For each power-relevant failure mode in .raw/micro-fc-failure-modes.md,
    states whether this board's design addresses it. Key result: the
    brownout/voltage-sag failure mode described in that research is the
    same finding as power-simulation-2026-08-16.md's buck duty-cycle
    margin issue, reached from the opposite direction -- one real risk,
    not two. Linear-regulator thermal failure is already addressed by the
    switching-buck-before-LDO architecture, confirmed quantitatively in
    the earlier analysis. ESC desync and a few others correctly ruled
    out as not applicable to this board's actual topology.
2026-08-16 Bench board PCB layout: 4-layer stackup, placement, ground plane -- not routed, not DRC-clean (documented)
    Synced 42 footprints from the finalized schematic. Added 2 inner
    copper layers (4-layer total); In1.Cu is a dedicated GND plane per
    the layout rules. 80x60mm outline -- generous, explicitly not whoop
    dimensions, this board never flies.
    Placement: force-directed auto-placement (suggest_placement) after
    manually anchoring the MCU, IMU, power section, USB, and headers.
    Verified 0 courtyard overlaps and 0 boundary violations before
    applying. IMU sits ~41mm from the switching regulator, satisfying the
    "don't place it near the switcher" rule -- computed from final
    coordinates, not assumed.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
    [bench_board.kicad_pcb]
2026-08-16 Rework power tree to single-stage buck (3.3V direct); add battery-sense divider
    Deletes the AMS1117 5V->3.3V LDO stage and its caps -- the 2-stage
    buck-then-LDO topology forced the buck to hold 5V from a 2S pack whose
    6.0V floor leaves only 1V of headroom (~83% duty cycle, at/past most buck
    ICs' practical limit). TPS563201 now regulates directly to 3.3V (feedback
    divider R1/R2 retargeted: 33.2k/10.0k, Vref=0.768V -> ~3.30V), which is
    what every load on this board (STM32F405, MPU-6000, DShot signal levels)
    actually wants. Duty cycle at 6.0V floor is now ~55%; at 8.4V ceiling
    ~39% -- comfortable across the whole battery range, both ends far from the
    TPS563201's ~90% max-duty limit.
    Inductor r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
    [bench_board.kicad_pcb, bench_board.kicad_sch]
2026-08-16 Re-sync PCB from reworked schematic; attempt Freerouting autoroute
    PCB was stale since the power-tree rework/battery-sense commit (a16eadb):
    sync_schematic_to_board only adds/updates footprints and net assignments,
    it does not delete footprints removed from the schematic or refresh Value
    text on ones that survived -- confirmed by inspection, not assumed.
    Manually closed both gaps: deleted U3/C4/C5 (the removed LDO stage) from
    the board, and pushed the schematic's new values onto the PCB (R1
    40.2k->33.2k, R2 7.32k->10.0k, L1 2.2uH->10uH, C3 2.2nF->100nF). Placed
    the 3 new battery-sense footprints (R9/R10/C22, synced in at the origin,
    stacked on top of each other) at (18.5, 26-32.5mm) -- clear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
    [bench_board.dsn, bench_board.kicad_pcb]
2026-08-17 Real ngspice verification of buck regulator (TPS54336ADDA), 4S+6S range
    Sources TI's own unencrypted PSpice average model for the part actually
    placed in the schematic (not the TPS54331DR documented in the 4S doc --
    a real discrepancy found this batch, see tooling-status.md). Verifies
    closed-loop startup, load-step, and regulation at 12.0V/14.8V/16.8V (4S
    range) and 25.2V (6S peak, never previously calculated for either
    regulator candidate). Recomputes output ripple at the part's real 340kHz
    switching frequency (the 4S doc used 570kHz, correct for the other part).
    Result: stable regulation and comfortable ripple/duty margin across the
    full 4S-6S range with a custom (non-TI-verified) compens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
2026-08-17 Resolve outstanding schematic WIP: fix stale 2S values, add missing compensation network, verify AC loop stability
    Item 1 review found the WIP wasn't just "uncommitted," it was incomplete
    and partly wrong -- read the actual diff before trusting it:
    - R1 was still the old 2S value (33.2k) despite the 4S doc already
    deriving 31.6k. Vout would have been 3.456V, not 3.3V. Fixed.
    - R9/R10 (battery-sense divider) were still 2S values (20.0k/10.0k,
    divide-by-3.0). Even the documented 4S-era fix (49.9k) doesn't have
    ADC headroom at true 6S peak (25.2V -> 4.2V on a 3.3V pin). Recomputed
    for real 6S safety: R9=75.0k (8.5x ratio, 2.965V at 6S peak). Firmware
    updated to match (see drone-firmw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
    [bench_board.kicad_sch]
2026-08-17 Archive superseded power docs to docs/superseded/, fix stale path references
    Same pattern as drone-firmware's inertia docs: three power analyses were
    competing in docs/ -- only power-spice-verification-2026-08-16.md is
    current. Moved the hand-calc analysis (power-simulation, done because no
    ngspice/SPICE models existed yet) and the 4S TPS54331DR verification
    (superseded by discovering the actually-placed part is a different IC,
    TPS54336ADDA) into docs/superseded/, each with a header block explaining
    what superseded it and why it's kept. Updated every remaining
    cross-reference (power-failure-modes-crosscheck, power-spice-verification,
    sim/tps54336_buck_verify.cir) to the new path. Left the tw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
2026-08-17 Fix stale schematic title-block text: 2S power description, three revisions out of date
    The schematic's own on-canvas summary text still described the original
    2S power tree (buck->5V, LDO->3.3V) despite the board having gone through
    the 4S rework (single-stage buck direct to 3.3V), the TPS54336ADDA
    part-swap discovery, and the 6S-safety battery-sense divider fix -- three
    revisions of real work the title block never reflected. Updated to
    describe the actual current design. ERC re-confirmed clean (0/0/0) after
    the edit. Re-exported wiki/_attachments/gallery/2026-08-16-schematic.pdf;
    the dashboard embed refreshes automatically (same filename).
    [bench_board.kicad_sch]
2026-08-17 Flag power-failure-modes-crosscheck.md as describing a superseded architecture
    Real finding from this batch's own new independent-review process: the
    prior commit (941cd9d) fixed this doc's path REFERENCES to the archived
    docs but left its substantive findings describing the original 2-stage
    2S design (TPS563201 buck -> AMS1117 LDO -> 3.3V) as if it were current
    -- directly contradicted by this same batch's own schematic title-block
    fix (503520b), which confirms the real board is single-stage
    (TPS54336ADDA direct to 3.3V, no LDO, no 5V rail at all). Added a warning
    header rather than moving it to docs/superseded/ (not one of the three
    doc-pairs this batch's item 4 was scoped to archive; a fu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
2026-08-17 Update magnetometer part choice to IST8310 (decided in drone-firmware item 13)
    Was left as an open "QMC5883L / IST8310-class" comparison. Now decided:
    IST8310, on the same real-KiCad-symbol-availability criterion the
    MPU-6000 IMU pick already used (IST8310 has one, QMC5883L doesn't). Full
    reasoning and the real driver landed in drone-firmware, not this repo --
    cross-referenced here since this is where the part-selection table lives.
2026-08-17 RX 5V rail (MT3608) + telemetry header into the schematic; ERC 0/0
    Item 1 of the board-finalization batch. Executes both lead decisions.
    RX POWER: MT3608 boost (LCSC C84817), 3.3V -> 5.0V, dedicated to the
    receiver. Verified rather than assumed, on the same criteria that picked
    the MPU-6000 and IST8310: native KiCad symbol exists
    (Regulator_Switching:MT3608), part is orderable at JLCPCB (Extended, not
    Basic -- setup fee applies), 162k in stock, $0.11 @1+.
    INPUT SIDE IS 3.3V, AND THE DATASHEET DECIDES IT: the MT3608's absolute
    maximum input is 24V, and this board is 6S-rated -- 6S peak is 25.2V.
    Battery-side input would exceed the part's rating by 1.2V at full charge.
    That is not a margin q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
    [bench_board.kicad_sch]
2026-08-17 Collision-avoidance provisioning: audit found 2 real conflicts, both fixed
    Item 2. Audited the expansion bus against the REAL pin budget and REAL
    datasheets rather than from memory, and it did not pass as-specified --
    two conflicts, both now resolved in the schematic.
    CONFLICT 1: PC10 was double-allocated. stm32f405-pin-assignment.md gives
    it to telemetry; expansion-bus-spec.md gives it to the bus as spare
    UART_TX. Item 1 of this batch made the collision concrete by wiring the
    telemetry header to it.
    Resolved by splitting USART3 by DIRECTION, which works because both users
    are unidirectional and opposite: PC10 TX to the ground station, PC11 RX
    from the forward lidar. Full-duplex hardware,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
    [bench_board.kicad_sch]
2026-08-17 Checkpoint: autoroute run + DRC that exposed a stale board (documented dirty)
    Autoroute completed (621 tracks, 86 vias, all 6 target nets, 4 attempts
    all converging on score 69501). Then DRC, run with --schematic-parity,
    came back 267 violations / 10 unconnected / 264 parity issues -- and the
    parity report explains the whole thing.
    THE BOARD WAS NEVER RE-SYNCED FROM THE SCHEMATIC. The PCB still carries
    the 2S-era power section:
    ref | board (stale) | schematic (current)
    ----+------------------------------+---------------------------
    U2 | TPS563201, SOT-23-6, 6 pads | TPS54336ADDA, SOIC-8-1EP
    J1 | BATT_2S | BATT_4S
    R1 | 33.2k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
    [bench_board.dsn, bench_board.kicad_pcb]
2026-08-17 Re-sync board to schematic, replace U2 properly, add In2 plane, re-route
    Fixes the stale-board defect from the previous commit. Full write-up in
    docs/stale-board-resync-2026-08-17.md.
    What changed:
    - U2 DELETED and re-placed from the library. Renaming the footprint
    field via edit_component was not enough and was actively harmful:
    it left the SOT-23-6's six lands under a SOIC-8 name, so the board
    was equally wrong but no longer advertised it. Correct geometry is
    13 pads (8 signal + thermal EP + 4 EP stitching).
    - J1/R1/R9/C1 values corrected to match the schematic. A scripted
    board-vs-schematic diff now shows zero value and zero footprint
    drift across all 55 parts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
    [bench_board.dsn, bench_board.kicad_pcb, bom_jlcpcb.csv]
2026-08-17 Item 6: fab package (gerbers, drill, CPL, BOM) -- marked NOT-READY-TO-ORDER
    fab/2026-08-17/ contains 11 gerber layers, Excellon PTH+NPTH drill with
    maps, a .gbrjob, pick-and-place for all 55 top-side parts, and a 38-line
    BOM with per-line sourcing notes.
    It is deliberately NOT marked ready to order. Two blockers, both stated
    at the top of the README rather than buried:
    1. 19 unconnected items, mostly U1's 3V3 supply pins (1,13,19,32,48,
    64) and GND pads with no via to the inner planes. An STM32 with
    floating VDD pins does not run. Needs manual routing in the KiCad
    UI; two scripted attempts are documented as failures.
    2. U2 (TPS54336ADDA, C1355769) showed as out of stock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
    [bench_board-B_Cu.gbr, bench_board-B_Mask.gbr, bench_board-B_Paste.gbr, bench_board-B_Silkscreen.gbr, bench_board-Edge_Cuts.gbr, bench_board-F_Cu.gbr, bench_board-F_Mask.gbr, bench_board-F_Paste.gbr]
2026-08-17 Add the mounting holes the board never had; re-route around them
    The board had NO mounting holes at all -- the only NPTH features were
    J3's two USB-C shell pegs. It could not have been bolted to anything.
    The standing placement rules call for 30.5x30.5mm and that had never
    been applied.
    Added 4 x M3 (3.2mm NPTH, 6mm pad) on the standard flight-controller
    pattern centred on the 80x60 board, at (24.75,14.75), (55.25,14.75),
    (24.75,45.25), (55.25,45.25). Positions were checked against every
    component first -- nearest neighbour is C2 at 3.6mm.
    Routing was cleared and redone so the router works around the holes
    rather than through them. Still ALL 51 nets: 509 tracks, 90 vias.
    The MCP wrote lib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
    [bench_board-B_Cu.gbr, bench_board-B_Mask.gbr, bench_board-B_Paste.gbr, bench_board-B_Silkscreen.gbr, bench_board-Edge_Cuts.gbr, bench_board-F_Cu.gbr, bench_board-F_Mask.gbr, bench_board-F_Paste.gbr]
2026-08-17 Correct four claims an independent review proved wrong
    The review checked this batch's hardware documents against the actual
    board file and found four statements that were not true. All are
    corrected inline, each saying what it replaced rather than being
    silently edited.
    1. "The inner layers are solid planes, which Freerouting detected and
    treated as such" -- FALSE. Freerouting's log says it configured them
    as power planes, then routed signals through them anyway: In1.Cu
    carries 97 segments across 24 nets, In2.Cu 90 across 24. Nets in the
    pours include SW_NODE (highest dV/dt node on the board), BOOST_SW,
    VBAT_4S (both inner layers), HSE_OUT, and VFB/VFB_5V/COMP_NODE.
    The G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
2026-08-17 Item 2: board blocker burn-down -- C23, Y1, C1, holes, net parity
    BLOCKER 4 CLEARED -- C23's net existed nowhere. The buck's compensation
    network is COMP_NODE -> R11 -> [nothing] -> C23 -> GND: the junction
    between R11 pin 2 and C23 pin 1 had no wire, so the TPS54336's control
    loop was not connected. Added the wire and a COMP_RC net label; ERC still
    0/0, and the net now appears on the board (52 nets, was 51). C23 is gone
    from the parity report.
    Y1 -- the board carried a 4-pin 3225 crystal footprint under a 2-PIN
    schematic symbol, which is why pads 3/4 were permanently unmatched in
    every sync. The only Basic-library 8MHz part (C115962) is a 2-pin
    SMD-5032. Delete-and-replaced to Crystal_SMD_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
    [bench_board.kicad_pcb, bench_board.kicad_sch, bench_board_constrained.dsn]
2026-08-17 Item 8: CFD/structural recommendation + material-independence rules
    docs/cfd-structural-recommendation-2026-08-17.md.
    Recommendation: DO NOT run CFD on the quadrotor; DO run it on the
    tiltrotor transition if that is ever built.
    Why not on the quad: the flow is rotor-dominated with no lifting
    surfaces, so it is unsteady at blade-pass frequency, needs moving
    reference frames or overset meshes, and is acutely sensitive to blade
    geometry that an off-the-shelf Gemfan prop does not publish. Weeks of
    work to produce a thrust curve the manufacturer already measured, more
    accurately, on a $60 thrust stand.
    What replaces it, in value order: vibration management (this project
    already has a concrete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
2026-08-17 Regenerate fab package from the fixed board; merge blockers 1+2
    All outputs regenerated from the board after C23 was reconnected, Y1 and
    C1 were re-footprinted, the mounting holes moved off nine components, and
    the net names normalised. Gerbers, drill, CPL (55 placeable parts, holes
    filtered out), plus the three SVGs and the 3D render.
    README restructured around the finding that blockers 1 and 2 are ONE
    problem, with the evidence inline: a fanout via at (27.90, 26.25) landed
    in a 5.5 x 0.8 mm ISLAND of 3V3 copper rather than the main pour, and
    (40,30) -- directly under the MCU -- is not covered by filled copper on
    either inner layer. You cannot via down to a plane that is not there, so
    the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
    [bench_board-B_Cu.gbr, bench_board-B_Mask.gbr, bench_board-B_Paste.gbr, bench_board-B_Silkscreen.gbr, bench_board-Edge_Cuts.gbr, bench_board-F_Cu.gbr, bench_board-F_Mask.gbr, bench_board-F_Paste.gbr]
2026-08-17 BOM: record this batch's verified sourcing
    Y1 moves Extended -> BASIC (C115962, SMD-5032-2P), the one removable
    setup fee the Extended audit found, and it came free with fixing a real
    defect: a 4-pin footprint under a 2-pin symbol.
    C1 respecified as 1210/50V X7R with the requirement stated as
    CAPACITANCE AT 16.8V BIAS. The earlier note confused voltage rating with
    bias derating -- a 35V 0805 at 16.8V also loses most of its capacitance,
    and 25V at 16.8V is not a rating violation at 1.49x margin. Bias
    derating is set by dielectric and case size, which is why the case grew.
    U2 stock resolved: 245 units, $1.0689/1, $0.8633/10+, verified against
    the LCSC part page rather than a search snippet.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
    [bom_jlcpcb.csv]
2026-08-17 Item 7: record tiltrotor provisioning against the real pin budget
    The lead ruling is provision-on-the-board, do-not-build-on-the-vehicle,
    so the question was whether the board can actually take it. Checked
    against the pin table rather than assumed.
    It can, cleanly. PC6-PC9 are TIM3_CH1-CH4 (AF2), also TIM8_CH1-CH4
    (AF3): four servo channels on ONE timer, so one timebase and four
    synchronised outputs, with no interaction with TIM4 which already drives
    DShot. Those four rows now record their timer capability instead of just
    saying "Free". Spare timer pins beyond them are listed too.
    An airspeed sensor -- mandatory for a tiltrotor, since the conversion
    corridor is defined in terms of airspeed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
2026-08-17 Fix the review's BLOCKER: the inner-layer fragmentation claim was wrong
    B1 (BLOCKER) -- I claimed the 15 unconnected pins were BLOCKED BEHIND
    fixing the inner layers, on the strength of a fanout via that "landed on
    a 5.5 x 0.8 mm isolated island of 3V3 copper". An independent review
    checked it against the committed board and it does not hold.
    THE EVIDENCE WAS AN ARTIFACT OF MY OWN PROBE. The via was placed at
    (27.90, 26.25), which is INSIDE the In1.Cu GND pour and OUTSIDE the
    In2.Cu 3V3 pour -- a 3V3 via dropped into the middle of the ground
    plane, where 3V3 copper does not reach. The zone filler then built a
    small 3V3 puddle around the via itself, and I read that puddle as proof
    of a shatt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
2026-08-17 Final DRC/ERC artifacts after the review fixes
    ERC 0 violations. DRC 46 / 15 / 88, unchanged by the doc corrections --
    the review's BLOCKER was about the INTERPRETATION of the board, not the
    board itself, so no copper moved.
    Claude-Session: https://claude.ai/code/session_013j3hUNiKQb8Wi66Tf5nVkP
2026-08-17 Item 0: tooling pre-flight -- FreeCAD route found, two item-6 inputs absent
    FreeCAD: there is NO freecad MCP (only kicad, github, gemini-cli and
    claude-in-chrome this session). Headless scripting IS the route and it
    works: FreeCAD 1.1.3 at a NON-STANDARD path,
    C:\Users\dmlam\AppData\Local\Programs\FreeCAD 1.1\bin\freecadcmd.exe --
    not under Program Files, which is why a naive check reports it missing.
    Verified by running real geometry rather than just launching it: box +
    cylinder, boolean cut (volume 590.575 mm3, correct), STEP and STL export
    both succeeded.
    One trap recorded because it aborts the whole script rather than
    warning: FreeCAD rejects MSYS-style paths. Import.export to
    "/tmp/x.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
2026-08-17 Item 1: two of the six safe fanout vias placed; unconnected 15 -> 13
    Placed ONE at a time with a full DRC after each, per the standing rule.
    No regressions: violations stayed at 46 through both.
    baseline 46 violations / 15 unconnected
    after U4.18 via 46 / 14
    after U1.32 via 46 / 13
    Both vias were sited with a checker that enforces the condition I skipped
    last batch: the location must be INSIDE the filled polygon of the plane
    carrying that pad's net, not merely near the pad. That is exactly the
    mistake that produced the bogus "isolated island" finding -- a 3V3 via
    placed inside the GND pour, where the filler built a puddle around it.
    U4.18 /GND -> via (50.827, 20.38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
    [bench_board.kicad_pcb]
2026-08-17 Item 2: per-net inner-layer cleanup -- target nets 28 -> 18 segments
    Approach that worked, and it is worth recording because it is the first
    time Freerouting has been usefully constrained on this board: delete the
    six EMI-critical nets ENTIRELY, then autoroute with the rest of the board
    left in place as fixed pre-routed wiring. Freerouting reported "78 SMD
    pins already connected" and touched only the deleted nets. 27 seconds.
    /HSE_OUT 5 -> 0 ** fully off the inner layers **
    /VBAT_4S 9 -> 5
    /HSE_IN 5 -> 4
    /SW_NODE 4 -> 4
    /VFB 3 -> 3
    /VFB_5V 2 -> 2
    total 28 -> 18 (-36%)
    DRC unchanged at 46 violations / 13 unconnected / 88 parity. No
    regression, no rule r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
    [bench_board.dsn, bench_board.kicad_pcb]
2026-08-17 Item 5 (hardware): buzzer on PA8 -- low-side MOSFET, placed and part-routed
    Q1 AO3400A low-side switch, R14 100R gate series, R15 10k pull-down, D2
    1N4148W flyback, C27 10uF local bulk, J10 2-pin header. PA8 chosen over
    several other free GPIOs because it is TIM1_CH1 and TIM1 is unused, so a
    passive buzzer with real tones stays possible with no board change. PA8's
    stale no-connect flag removed; ERC is 0/0.
    An F4 pin is rated 25 mA and a 12 mm buzzer draws 30-90 mA, so the FET is
    not optional. D2 is fitted even though a piezo buzzer would not need it --
    two cents to make the board buzzer-type-independent.
    THE PLACEMENT WAS WRONG FIRST TIME. Q1 and C27 landed on top of a 15.7 mm
    NRST track f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
    [bench_board.kicad_pcb, bench_board.kicad_sch]
2026-08-17 Item 6: parametric 350-class frame v0 in FreeCAD -- both material variants
    mechanical/frame-v0/frame_v0.py builds the whole frame from one PARAMETERS
    block and runs headless under freecadcmd (there is no FreeCAD MCP on this
    machine -- item 0 established that). Sandwich X quad: four flat arms bolted
    between a bottom and a top plate.
    MATERIAL INDEPENDENCE DRIVES THE SHAPE, not a note at the end. Because the
    frame must build as printed PETG-class OR as cut carbon plate, every
    structural part is a flat profile of constant thickness -- no draft, no
    ribs, no bosses, nothing only a printer can make. The same outline is
    printed or cut off the same DXF, and the DXF is exported. Thickness is the
    only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
    [part-arm-1-cf.stl, part-arm-1-petg.stl, part-bottom-plate-cf.stl, part-bottom-plate-petg.stl, part-top-plate-cf.stl, part-top-plate-petg.stl, stevie-frame-v0-cf.step, stevie-frame-v0-cf.stl]
2026-08-17 Item 6 follow-up: drill BOTH motor patterns -- the chosen motor did not fit
    Found while writing the thrust procedure against the parts list. Item 6
    specified a 2212-class pattern, which is a 16x19 cross. The motor this
    project has actually chosen is the iFlight XING X2814, whose pattern is a
    19x19 SQUARE. A square does not fit a cross, so the frame as first built
    would not have accepted the project's own motor.
    Both patterns are now drilled -- eight M3 on one pad, which is what
    commercial frames in this class do.
    The pad was 32 mm and the script's own geometry check REJECTED it: the
    square's corner holes sit at r=13.44, leaving under 1 mm of material
    outside the hole edge, which is a bolt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
    [part-arm-1-cf.stl, part-arm-1-petg.stl, stevie-frame-v0-cf.step, stevie-frame-v0-cf.stl, stevie-frame-v0-flats-cf.dxf, stevie-frame-v0-flats-petg.dxf, stevie-frame-v0-petg.step, stevie-frame-v0-petg.stl]
2026-08-17 Item 8 prep: fab package marked stale, fanout guide 13 -> 15 items
    The fab/2026-08-17 Gerbers predate items 1+2 (two fanout vias, inner-layer
    cleanup) and item 5 (the buzzer -- six components and their copper are
    missing from those files entirely). Bottleneck #5 in the last report said
    "upload engineering/drone-hardware/fab/2026-08-17/", which would now order
    the wrong board. Banner added at the top of that README.
    Also recorded there: before regenerating, the board's stored zone fill must
    be refilled in the KiCad UI, because it predates the buzzer footprints and
    has no antipads for J10's two through-holes.
    manual-fanout-guide updated 13 -> 15 remaining ratsnest items, with the two
    new one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
2026-08-17 Independent review: fix the frame's broken slots and make padclear real
    HIGH -- all four battery-strap slots broke out through the plate outline.
    Slot centres at x = +-56.5 put their outer ends at x+y = 98.75, and the
    octagon's chamfer is x+y = 95. So every exported STL, STEP and DXF had
    four OPEN NOTCHES, ~4.4 mm wide against a 3.5 mm slot -- a strap would
    have slid straight out. The review found it by reading the mesh.
    Slots moved to +-46, and the script now CHECKS it: every hole and slot
    corner is tested against the real outline, chamfers included, with 2 mm
    to spare. Verified in the rebuilt mesh -- the rounded tip arc is present
    and no vertex sits on the chamfer line. The check it repla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
    [part-bottom-plate-cf.stl, part-bottom-plate-petg.stl, stevie-frame-v0-cf.step, stevie-frame-v0-cf.stl, stevie-frame-v0-flats-cf.dxf, stevie-frame-v0-flats-petg.dxf, stevie-frame-v0-petg.step, stevie-frame-v0-petg.stl]
2026-08-17 Item 0: tooling pre-flight -- headless pcbnew Python found, the item-3 route
    KiCad ships its own interpreter at bin/python.exe with pcbnew bound
    (10.0.5, ZONE_FILLER present). Verified by loading the real board rather
    than by importing the module: 65 footprints, zones enumerate correctly.
    That is a genuinely different code path from the MCP refill that shattered
    the planes last batch.
    A counting correction that matters for item 3's measurement: this board
    has TWO copper pours, not three. The third (zone ...) block is a keepout
    INSIDE a footprint -- no net, no fill -- which is why pcbnew's Zones()
    returns 2 while a naive regex over the file returns 3. Baseline fragment
    counts from committed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
    [stevie-frame-v0-cf.step, stevie-frame-v0-petg.step]
2026-08-17 Item 1: the 30.5 mm mounting pattern is restored, and asserted from the files
    The holes went back to (24.75,14.75) (55.25,14.75) (24.75,45.25)
    (55.25,45.25) -- exactly where commit 4f49241 first put them, and exactly
    30.5 x 30.5 centred on the board. Commit 4cf2faf had scattered them to the
    corners to dodge components; per the lead ruling the components move
    instead, because the standard exists so hardware interchanges.
    WHAT WAS IN THE WAY, found by moving the holes first and letting DRC say:
    MH1 nothing -- the /BOOT0 tracks clear it by 2.27 mm
    MH2 /EXP_SPI_MISO on In1.Cu
    MH4 /NRST on F.Cu, /SWDIO and /SWCLK on In1.Cu (SWCLK ran through the
    hole centre -- 0.043 mm on the wr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
    [bench_board.kicad_pcb]
2026-08-17 Kill a blocking-dialog hazard in headless pcbnew (unattended-batch stall)
    PCB_VIA::GetWidth()/SetWidth() trip a wxWidgets debug assert on KiCad 10
    ("called without a layer argument"). Interactively that is a modal dialog;
    in an unattended batch it waits forever for a click nobody is there to
    give, and the run looks hung rather than broken. It fired from viasite.py
    while searching for a via site.
    scripts/kicad_safe.py is now the shared preamble for every headless pcbnew
    script here, and does both halves of the fix:
    1. wx.DisableAsserts() on import, before any board is touched, so no
    script can forget it and no FUTURE assert of this class can stall a
    run either. Verified: asserts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
2026-08-17 Item 2: the buzzer's own routing is closed; the rest is proven not scriptable
    BOTH buzzer nets are now routed and DRC-clean. Unconnected 15 -> 13.
    /BUZZER_GPIO -- the wire without which the buzzer is fitted and silent --
    runs U1 pad 41 to R14 on B.Cu, which had only 19 segments on it against
    F.Cu's 322. Two vias, sites chosen by a clearance search rather than by
    eye. The first attempt ran the B.Cu leg 0.21 mm from a /3V3 fanout via
    (DRC: shorting_items); the leg is now jogged to x=41.7 and clears it by
    0.27 mm.
    /5V_RX ties the buzzer's local island (D2/C27/J10) back to the boost rail
    at J7. Also B.Cu, and no vias at all -- both ends are through-hole pads,
    so the back layer reaches them dir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
    [bench_board.kicad_pcb]
2026-08-17 Item 3: headless pcbnew ZONE_FILLER refills the planes correctly
    The MCP refill shattered both inner planes last batch (In1.Cu 2 -> 19
    filled polygons, In2.Cu 1 -> 22) and that fill was discarded. KiCad's own
    in-tree filler, called through KiCad's own interpreter, does not:
    /GND on In1.Cu 2 -> 2 polygons
    /3V3 on In2.Cu 1 -> 1 polygon
    Measured the same way on both sides -- filled-polygon count read out of
    the board file -- because a comparison across two different measurements
    is what produced last batch's phantom "281 violations" baseline.
    Coverage confirms it is the SAME plane, not merely an un-fragmented one:
    3291.2 -> 3296.6 mm2 on In1.Cu and 3089.6 -> 3092.2 mm2 on In2.Cu, the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
    [bench_board.kicad_pcb]
2026-08-17 Item 4: fab package regenerated as fab/2026-08-17b/
    Fresh gerbers (11 layers), PTH/NPTH Excellon drills with maps, CPL, BOM,
    and a DRC+parity run, all from the board after items 1-3.
    THE COMPLETENESS CHECK THE ITEM ASKED FOR, done by diff rather than by
    eye: cpl_top.csv holds 61 rows against 61 placeable components on the
    board -- nothing missing, nothing extra. All six components the old
    package lacked (Q1, R14, R15, D2, C27, J10) are present.
    The four mounting holes are deliberately EXCLUDED from the CPL. kicad-cli
    includes them by default; telling an assembler to place an NPTH hole is
    how you get a support ticket. The old package excluded them too, so the
    55 -> 61 delta is exactly the s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
    [bench_board-B_Cu.gbr, bench_board-B_Mask.gbr, bench_board-B_Paste.gbr, bench_board-B_Silkscreen.gbr, bench_board-Edge_Cuts.gbr, bench_board-F_Cu.gbr, bench_board-F_Mask.gbr, bench_board-F_Paste.gbr]
2026-08-17 Item 6: frame v0.1 -- clearance ruling recorded, landing gear, fastener BOM
    ALL 16 GEOMETRY CHECKS NOW PASS, both variants.
    PROP CLEARANCE ACCEPTED. The lead ruled 8.3 % acceptable, so the script no
    longer reports it as a FAIL -- a standing failure that will never be fixed
    only teaches people to skim the report. It still prints the number in
    full; accepting a figure is not the same as hiding it.
    The precedent is recorded CHECKED rather than repeated: a Phantom 3 on
    this same 350 mm class has adjacent spacing 247.49 mm and 9.4 in props =
    238.76 mm, so its tip gap is 8.73 mm = 3.7 % -- less than half this
    frame's, flight-proven at scale. The arithmetic is in the build report so
    nobody has to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
    [part-foot-1-cf.stl, part-foot-1-petg.stl, part-leg-1-cf.stl, part-leg-1-petg.stl, stevie-frame-v0-cf.step, stevie-frame-v0-cf.stl, stevie-frame-v0-flats-cf.dxf, stevie-frame-v0-flats-petg.dxf]
2026-08-17 Item 8: final DRC/parity artifacts and the board render
    kicad-cli DRC with --schematic-parity, verbatim: 54 violations, 13
    unconnected, 93 parity issues. 54 is below the 64 this batch started at.
    Every rerouted net verified CONTINUOUS, not merely DRC-quiet: only /3V3
    and /GND appear in any unconnected item, so /SWCLK, /SWDIO, /NRST,
    /VBAT_4S, /SW_NODE, /EXP_SPI_MISO and all four buzzer nets are whole
    end to end. That matters because two reroutes this batch were done twice
    after a tool deleted segments it was not asked to.
    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
2026-08-17 Fanout guide: replace the estimate with the measured channel width
    The guide said the escape channel "is smaller than the smallest legal
    via". Measured off the board rather than estimated, it is 4.5x too narrow:
    U1's pads are 0.300 mm wide on a 0.500 mm pitch, so the gap is 0.200 mm,
    and the smallest legal via here needs 0.900 mm of channel (0.500 dia plus
    2 x 0.200 clearance).
    Worth numbers rather than an adjective: this is the sentence that justifies
    telling a human to do the work by hand, so it should be checkable.
    (First attempt at this edit used a "run to the next blank line" heuristic
    and deleted the whole surrounding section, including the 13-item list and
    the struck-through J3 corr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
2026-08-17 Record why the fragment-count check is not sufficient on its own
    A plane can be badly fragmented while keeping the same filled-polygon
    count -- one polygon with a void through it, joined by a thread, still
    counts as one. So the item-3 conclusion does not rest on that number
    alone, and the doc should not imply it does.
    Three independent measurements, all agreeing: polygon count (2 and 1,
    matching git), coverage area (unchanged to within 0.2 %), and -- the one
    that actually speaks to connectivity -- isolated_copper from DRC, which
    is ZERO where the MCP's shattered fill produced 41. via_dangling is 0 too.
    Recorded because the count is the cheap check and DRC is the real one, and
    someone readi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
2026-08-17 check_fc_pattern: fail if the DXF is older than the script that makes it
    The check reads the exported DXF rather than frame_v0.py's FC_MOUNT
    constant, deliberately -- the constant is what the frame intends, the DXF
    is what a cutter would actually make. But that reasoning only holds if
    the DXF is current. A stale export would let the check pass against an
    artifact nobody would build, which is the same failure mode as a checker
    that measures the wrong thing.
    Mutation-tested: touching frame_v0.py makes the check fail with the
    staleness in seconds, and regenerating the exports clears it.
    Claude-Session: https://claude.ai/code/session_013j3h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
    [stevie-frame-v0-petg.step]
2026-08-17 Correct the headline blocker's description: 13 connections, 15 pads, not '12 processor pins'
    Checked the DRC file instead of re-reading my own summary. The 13
    unconnected items span 15 pads -- 8 on U1, 3 on U4, 4 on J3's USB-C
    shield -- and two of the thirteen touch no chip at all. The claim that
    twelve were 'the processor's own power pins' folded the IMU and the
    connector shield into the MCU's count, and called connections 'pins'
    when a ratsnest item joins two pads.
    The conclusion is unchanged and still correct: the board cannot be
    ordered, because U1's supply pads are among them.
    docs/manual-fanout-guide-2026-08-17.md was right all along -- it lists
    the thirteen items rather than summari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
2026-08-17 Frame: derive the precedent comparison; stop tracking Python bytecode
    Two small things, both found by re-running the frame script and reading
    its output instead of trusting it.
    frame_v0.py printed a literal '%%' -- the string is not %-formatted, so
    the escape leaked into a line David reads. Alongside it, '8.3 %' was
    hardcoded in prose directly beneath a computed 8.26 %, and 'less than
    HALF' was an arithmetic claim written as a constant. All three are now
    derived from TIP_GAP_PCT and the Phantom 3 figures, so the sentence
    cannot drift away from the geometry: if the tip gap fell to 7 %, the
    line reads '1.9x less than' rather than continuing to claim HALF.
    Mutation-checked at 7.0 % and 5.0 %.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
    [stevie-frame-v0-petg.step]
2026-08-17 BLOCKER: the landing gear is 14 mm in the model and was published as 2-4 mm
    Found by independent review. build_leg() extrudes the web by LEG_W
    (14.0), not ARM_T -- so the leg is a 14 mm slab, identical in both
    builds. Three documents said otherwise, and the geometry check that
    should have caught it tested ARM_T, a variable the leg never uses:
    setting LEG_W to 0.5 mm left it printing 'OK 4.0 mm'.
    Worse, leg_1 and foot_1 were in stevie-frame-v0-flats-cf.dxf, which the
    README calls 'what makes the carbon option real'. Cutting leg_1 from 2 mm
    CF gives (2/14)^3 = 1/343 of the modelled sideways stiffness, and the
    M3x20 bolts -- sized 14 + 6 -- protrude 12 mm.
    RESOLUTION: the 14 mm leg is correct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
    [stevie-frame-v0-cf.step, stevie-frame-v0-flats-cf.dxf, stevie-frame-v0-flats-petg.dxf, stevie-frame-v0-petg.step]
2026-08-17 Fanout checker: true pad geometry, stub-vs-via, and a census of WHY
    Independent review flagged that the guide's stated REASON for zero legal
    fanout sites was wrong. Checking it turned up two more defects in the
    checker itself, and the reviewer's own diagnosis does not survive either.
    place_fanouts.py modelled every pad as a disc of radius hypot(w,h)/2. For
    U1's 1.55 x 0.30 mm LQFP pad that is a 0.789 mm disc against a true
    half-height of 0.15 mm -- inflating the obstacle by 0.639 mm, more than
    3x the 0.2 mm clearance rule. With true rotated-rectangle distance,
    U4.11 went from 0 legal sites to 29.
    I placed one and let DRC judge. It found a NEW clearance violation:
    'Track [/GND] length 1.600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
2026-08-17 Fanout guide: the escape channel is 1-22% of the reason, not the reason
    The guide told a human to 'drag the one or two signal traces that own the
    escape channel'. The census says that would burn a session: the VIA BODY
    accounts for 78-99% of rejected sites and the stub for 1-22%. The
    neighbourhood out to 3 mm is saturated, not pinched at one point.
    And for U1.1, U1.64 and U1.48 the /3V3 plane does not reach ANY candidate
    site, so no amount of trace-dragging finishes them -- the pour has to be
    extended first. That much of the review's finding stands, and it is the
    actionable half.
    The escape-channel arithmetic (0.200 mm available vs 0.900 mm needed)
    stays, because it is true and it is why a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
2026-08-17 check_fc_pattern: an M3 has to fit through the hole, not just line up
    From the independent review. The script checked that the four board
    drills matched EACH OTHER and never compared them to anything. Mutating
    all four to 2.0 mm left it printing
    ok: board holes are all the same drill size [2.0] mm
    ok: the board bolts to the frame (patterns are congruent)
    PASS: the board's mounting pattern matches the frame's FC standard
    and exiting 0, for a board no M3 bolt passes through. Matching each other
    is not the property that matters; matching the bolt is. Two checks added:
    the drill clears an M3 (3.2 mm), and it agrees with the frame's own hole
    diameter read from the DXF. Reproducing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
2026-08-17 Fanout guide: one 15-to-13 credited to two different causes; strike a third stale claim
    Measured rather than reasoned: DRC on the board as stored at each commit
    gives 6013565 (item 1) = 15 unconnected, 9442793 (item 2) = 13. So the
    drop is item 2's buzzer routing. The two fanout vias predate this batch
    and are worth 2 items, but they are not what moved this batch's count.
    Both misattributions corrected, with the measurement recorded.
    Also struck: 'Job A ... fixes J3's four through-hole shield pads for
    free'. That claim was disproved earlier in this same batch and the
    correction sits a few hundred lines above in the same file -- it just
    had not been carried down to the recommendation the rea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
2026-08-17 Item 0: batch-5 pre-flight -- freecadcmd confirmed, NO SWD tooling, CCM verified
    freecadcmd 1.1.3 confirmed headless (it has been driving frame_v0.py all
    day), so item 6 has its interpreter. Non-standard install path and the
    MSYS-path rejection both re-recorded.
    The finding that shapes item 1: there is NO SWD tooling on this machine
    and no probe attached. openocd, st-flash, st-info, STM32_Programmer_CLI,
    dfu-util, pyocd and JLinkExe are all absent -- not just off PATH, a
    directory sweep of both Program Files trees finds no install -- and
    Get-PnpDevice matching ST-Link/J-Link/CMSIS-DAP returns nothing.
    So item 1 ships tooling plus a dry-run mode, and the live-probe step is
    untestable here.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
2026-08-18 Item 5: checker-falsifiability audit, made executable and standing (B4)
    Eleven checks, each deliberately broken once to confirm it notices. All
    eleven are falsifiable; nothing had to be deleted.
    scripts/falsifiability_audit.py is the audit as an ARTIFACT rather than a
    prose table. It runs each check clean, applies one representative defect,
    runs it again, restores the file and VERIFIES the restore. It exits
    non-zero if any check survives its own mutation, which is what makes it
    usable as a standing wrap item instead of a one-time exercise. Added to
    the wrap checklist in next-task.md.
    Cases: frame leg thickness, frame ground clearance, sheet-only DXF,
    mounting pattern vs an M3, DXF stalenes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
2026-08-18 Item 6: full-assembly CAD, every component in position (B6)
    mechanical/assembly-v0/assembly_v0.py places frame, board, battery, ESC
    stack, four motors, prop discs, receiver, antenna keep-out, buzzer and the
    expansion access volume in one model. Seven checks, 54 interference pairs,
    STEP + STL + plan SVG, and a generated mass/CG/inertia doc.
    ZERO EDITS TO THE BOARD OR THE FAB PACKAGE, as required. The board enters
    read-only via mechanical/bench_board.step.
    PARAMETERS ARE IMPORTED, NOT COPIED -- and making that true meant
    extracting frame_params.py, the 163 lines of constants both frame_v0.py
    and the assembly now share. It is deliberately FreeCAD-free, so ordinary
    python can read it. The boar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
    [frame_params.py, frame_v0.py]
2026-08-18 wip: batch-5 review fixes (checkpoint before audit verification)
    [stevie-frame-v0-petg.step]
2026-08-18 Review fixes: the audit cleans up after itself, and covers the guards it missed
    H5: the audit left the repo dirty every run -- FreeCAD stamps a fresh
    timestamp into every STEP on regeneration, so each wrap produced a
    124,000-line spurious diff, training exactly the git-checkout habit that
    discards real regenerations. It also deleted a build report the wrapper
    could not recreate. The audit now snapshots every generated artifact
    (STEP/STL/DXF/SVG/report/doc) before anything runs and restores them
    byte-for-byte at the end, reporting what it disturbed. Verified: a full
    17-case run leaves git status clean.
    M1: the regeneration hook called freecadcmd directly and discarded the
    return value, viola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
2026-08-18 Assembly: the exploded render the brief asked for
    Item 6 required exploded AND assembled; only the assembled plan shipped.
    The elevation is the more useful of the two here -- the plan shows the
    footprint, but the STACK (pack under the plate, ESC on it, board on
    standoffs above) is what is hard to hold in your head from a parts list,
    and it is where the clearances are.
    run_freecad_check.py caught a syntax error in this very addition and
    refused the run, which is exactly the hazard it was built for four hours
    ago: bare freecadcmd would have exited 0 and left yesterday's exports
    looking current.
    Claude-Session: https://claude.ai/code/sessi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
2026-08-18 Item 0: batch-6 pre-flight -- kicad-cli 10.0.5, wx-assert preamble verified EXECUTING
    kicad-cli runs and reports 10.0.5 (the item-1 guard is built on it). The
    kicad_safe preamble is not just present in all 12 pcbnew-importing
    scripts -- importing it through KiCad's own interpreter confirms
    _ASSERTS_OFF is True at runtime, so no assert dialog can hang an
    unattended run.
    Standing constraints restated where the batch will trip over them: MCP
    refill still banned, refill_zones.py is the only refill path; the
    routing-attempt ban is lifted for THIS BATCH ONLY under item 1's guard
    contract; the current design rules' smallest legal via is 0.50/0.30 and
    any rule change toward JLCPCB's real capability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
2026-08-18 Item 1: board_guard.py -- the revert contract, proven before anything touches the board
    The guard runs the REAL kicad-cli DRC (--severity-all
    --schematic-parity), parses violations/unconnected/parity, and compares
    against a stored baseline. On ANY count increasing it reverts the board
    file to HEAD immediately and logs the failed attempt. Attempt 3 of the
    prior three (43 violations -> 235 -> 387) is exactly what happens
    without this: every edit judged by the model that proposed it.
    Baseline recorded verbatim: 54 violations / 13 unconnected / 93 parity,
    board sha256 502b23935fc5. Git tag batch6-board-baseline marks the
    revert target for the whole batch.
    PROVEN TO FAIL before first use: one t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
2026-08-18 Board: J3.A1 -> B12, 1.31 mm on F.Cu. Unconnected 13 -> 12 (guard-verified)
    The batch hypothesis (extend zone outlines) is refuted for all seven
    coverage pads -- both outlines are 4-vertex rectangles already covering
    every pad by 7-24 mm; the deficits are carved by clearance to protected
    copper, which no outline edit reaches. pour_reach.py records the per-pad
    evidence.
    What the probing DID find: DRC's own ratsnest arithmetic proves J3's PTH
    shield pads B1/B12 are ALREADY plane-connected (thermal spokes), and the
    SMD shields A1/A12 sit 1.31 mm from them across a clean F.Cu corridor.
    So A1 closes with one 0.2 mm surface trace to B12's annulus -- no via,
    no zone edit, no contact with the 214 p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
    [bench_board.kicad_pcb]
2026-08-18 Board rules: min_copper_edge_clearance 0.5 -> 0.3 (guard: 53/12/93, one baseline violation cleared)
    A DELIBERATE, CITED rule change, not a dodge. 0.5 was the KiCad default,
    not a fab limit: JLCPCB's published capability is 0.2 mm copper-to-NPTH
    and 0.3 mm trace-to-outline for routed edges. 0.3 keeps the stricter of
    the two with margin over their +-0.15 routing tolerance.
    Why now: J3.A12 is geometrically SEALED under the 0.5 rule. Its only
    corridors are bounded by a milled NPTH slot (0.95 mm tall after the
    connector's 90-degree rotation), A11's pad, the B-row annuli and a
    /USB_VBUS run -- the band between slot rim and A11 needs a centreline at
    y>=27.475 but A11 caps it at 27.373. Empty at 0.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
2026-08-18 Board: J3.A12 -> SH tab, threaded. Unconnected 12 -> 11 (guard: 53/11/93)
    A12 took all three strikes:
    1. The straight A12->B1 mirror trace: guard-reverted (56/11/93). The
    killer is an NPTH slot 0.95 mm TALL after the connector's rotation,
    with the milled-slot edge rule, not the round peg the passing A1
    side skirts.
    2. A dipped path through the computed legal band: guard-reverted
    (55/11/93). My band math used the 0.127 board minimum where the
    Power netclass demands 0.2 -- both new violations were exactly the
    A11 and B2 gaps at 0.175.
    3. This: a 3-segment thread UP and AROUND the slot to the connector's
    own shield tab (plane-connected through its spoke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
    [bench_board.kicad_pcb]
2026-08-18 Board rules: via minimums set to JLCPCB's published 4-layer capability
    min_via_diameter 0.45 -> 0.25, min_through_hole 0.30 -> 0.15,
    min_via_annular_width 0.10 -> 0.05. These were KiCad defaults, not fab
    limits: JLCPCB's 4-6 layer capability is 0.15 mm via hole / 0.25 mm via
    diameter, and the fab package targets exactly that process.
    Why it matters: the batch-4 impossibility proof was computed at the OLD
    minimum legal via (0.50/0.30, needing an r=0.45 clear disc). At 0.30/0.15
    the disc shrinks to r=0.35 and, decisively, a via fits AT AN SMD PAD TIP
    where neighbouring-pad clearance is exactly the 0.2 class value. Combined
    with B.Cu (19 segments on the whole board) as the escape layer, every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
2026-08-18 Board: U4.11 closed -- tangent 0.30/0.15 via + B.Cu leg to the existing GND via. 11 -> 10
    The pattern the rest of the batch now follows: a small via touching the
    pad (drill fully OUTSIDE the pad copper here, so no via-in-pad fee), a
    0.15 mm B.Cu leg across the nearly-empty bottom layer, landing on an
    already-plane-connected annulus at (50.83, 20.38). The via needs no fill
    under it -- B.Cu carries the connection -- which is the requirement that
    doomed the batch-4 search.
    Corridor verified against the full B.Cu map before applying: /MPU_INT
    via 0.26 clear, /MPU_CPOUT run 1.09 clear, /EXP_I2C_SDA diagonal does
    not overlap this x-range. Guard: 53/10/93, ratcheted.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
    [bench_board.kicad_pcb]
2026-08-18 Board: refill after the U4.11 via -- planes coherent (2/1 polys), guard 53/10/93 unchanged
    The standing sequence for every via from here on: addroute -> refill ->
    guard. U4.13's first attempt proved why: its two new 3V3 vias collided
    with the STORED In1 GND fill (clearance + hole_clearance at both
    positions), because the fill predates the vias. The refill regenerates
    the antipads; the guard then judges the real state.
    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
    [bench_board.kicad_pcb]
2026-08-18 Board: U4.13 closed -- stub + tip via + B.Cu leg + landing via. 10 -> 9 (guard 53/9/93)
    Attempt 2, with the refill in the loop. Attempt 1 connected (10 -> 9)
    but collided with the stored In1 GND fill at both new via positions --
    the exact class of error the guard exists to catch, and it did.
    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
    [bench_board.kicad_pcb]
2026-08-18 Board: U1.13 closed -- in-pad 0.30/0.15 via + B.Cu to a landing under the chip body. 9 -> 8
    First of the in-pad set: the via drill sits inside the 0.30 mm-wide LQFP
    pad, so this pad joins the epoxy-fill-and-cap list for the order sheet.
    The exact-0.200 clearance to the neighbouring pad passed DRC as computed.
    Guard 53/8/93, ratcheted.
    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
    [bench_board.kicad_pcb]
2026-08-18 Board: U1.19 closed -- in-pad via + B.Cu leg. 8 -> 7 (guard 53/7/93)
    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
    [bench_board.kicad_pcb]
2026-08-18 Board: U1.63 closed -- in-pad via + B.Cu leg. 7 -> 6 (guard 53/6/93)
    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
    [bench_board.kicad_pcb]
2026-08-18 Board: U1.12 closed on attempt 2 -- western B.Cu detour. 6 -> 5 (guard 53/5/93)
    Attempt 1's direct leg was blocked by MY OWN U1.13 route -- the two
    squeeze the same inter-pad corridor, and the guard caught the collision
    between the new GND leg and the day-old 3V3 leg (0.324 mm where 0.425 is
    needed). The detour runs south, west past the CS1/VCAP1/HSE_IN via
    minefield with verified berths (min 0.61 mm centre distance), north
    outside it, then into the same landing. 9.3 mm of B.Cu for one pin, and
    worth it.
    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
    [bench_board.kicad_pcb]
2026-08-18 Board: U1.1 closed -- 0.65 mm F.Cu stub through the /EXP_SPI_CS1 shadow, tip via, B.Cu leg. 5 -> 4 (guard 53/4/93)
    CS1 runs the whole left column on In1.Cu 0.665 mm from the pad centres,
    which is what killed every tip and in-pad site here: a through-via body
    cannot clear it. The site at lon 1.425 is past CS1's shadow; the stub
    that reaches it lives on F.Cu and legitimately flies OVER CS1 -- the
    checker itself had to be taught that (it was testing F.Cu stubs against
    inner-layer segments and rejecting every site on the column).
    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
    [bench_board.kicad_pcb]
2026-08-18 Board: U1.18 closed -- deep in-pad via (lon 0.15) + B.Cu dodge around VBAT_SENSE. 4 -> 3 (guard 53/3/93)
    The site search's floor was lon 0.30, where /VCAP1 on In2 blocks by
    48 um; the blocker FADES INWARD and lon 0.10-0.25 is legal. The search
    tool encoded an assumption the geometry did not share.
    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
    [bench_board.kicad_pcb]
2026-08-18 Board: U1.64 closed -- 1.6 mm interior diagonal to the now-connected pad 1. 3 -> 2 (guard 53/2/93)
    U1 has no interior keepout (U4 does -- its 'empty' interior turned out to
    be enforced by a rule area, which is what killed U4.1's third strike).
    Pad 64's own tip band is blocked on three layers at once (my new U1.63
    GND leg on B.Cu, /EXP_SPI_CS1 and /CRSF_RX on In1), but its corner
    neighbour pad 1 is 3V3 and now plane-connected, and the LQFP interior
    between their inner tips is genuinely empty.
    THE SCORE: 11 of 13 closed. The two remaining are each proven
    unclosable in scope three independent ways:
    U1.48 [3V3/VDD_3]: the /EXP_I2C_SDA B.Cu diagonal passes essentially
    through the pad positi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
    [bench_board.kicad_pcb]
2026-08-18 C23: 7.5nF -> 8.2nF (LCSC C107032) per ngspice loop-gain study; ERC 0, guard 53/2/93
    8.2nF raises phase margin at both corners (+1.2 deg at 14.8V and 25.2V)
    where 6.8nF lowers it; crossover unchanged within 0.5%. JLCPCB stocks no
    7.5nF MLCC. Study harness and results in sim/. Board+schematic value
    edited together; guard re-run PASS 53/2/93, ERC 0 violations.
    [bench_board.kicad_pcb, bench_board.kicad_sch]
2026-08-18 C1 resolved: GCM32EC71H106KA03 (LCSC C126612) verified at 16.8V bias
    Murata PIM bias curve read directly: -21.15% at 16.8V -> 7.89uF nominal,
    5.54uF at full worst-case stack; TPS54336A ripple-voltage and
    ripple-current requirements pass at every corner. BOM's example part
    GRM32ER71H106KA12L is EOL at Murata (NRND across the GRM32 50V 10uF
    line). New BOM row lands in fab/2026-08-17c.
2026-08-18 J3 resolved: no JLCPCB-stocked USB-C is pad-compatible -- hand-fit the genuine Amphenol
    Measured every candidate family against the board's actual pad table via
    EasyEDA footprint pulls: QCHT/HRO hybrids have B-row cols 0.10mm off and
    rear shield legs 1.6mm short of the board slots (cannot seat); stocked
    Amphenol siblings (C464604, C5119948) are dual-SMT B-row variants whose
    feet land across the open staggered B holes. Exact 12401548E4 not in
    catalog. J3 goes on the order sheet as hand-fit from Digi-Key/Mouser;
    B-row+shield-only soldering yields a working USB 2.0 port.
2026-08-18 Item 5: fab package 2026-08-17c + ORDER-SHEET; 17b marked superseded
    Fresh gerbers/drill/CPL/BOM/DRC from board 8b12e0c (53/2/93 verbatim).
    check_cpl.py PASS 61/61. BOM: every assembly line now carries an LCSC
    part -- C1 C126612, C23 C107032, R1 C11463, R12 C14890, R14 C25076,
    R15 C25744, C27 C15850, L1/L2 candidate C17701247 with the saturation
    math stated; J3 marked HAND-FIT with measured justification. Order
    sheet specifies Epoxy Filled & Capped vias as MANDATORY (verified
    offered on 4-layer, holes 0.15-0.55mm covers our 0.15-0.40mm), lists
    the exact in-pad pads from a geometric audit of the board file, the
    nine hand-soldered headers, the two sub-mm bench bridges, and STOP
    conditions for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
    [bench_board-B_Cu.gbr, bench_board-B_Mask.gbr, bench_board-B_Paste.gbr, bench_board-B_Silkscreen.gbr, bench_board-Edge_Cuts.gbr, bench_board-F_Cu.gbr, bench_board-F_Mask.gbr, bench_board-F_Paste.gbr]
2026-08-18 Batch 6 review fixes: the bench fix that could not be performed, and seven more
    Independent review (fresh agent, read-only) returned 1 BLOCKER, 3 HIGH,
    6 MEDIUM, 6 LOW. Acted on here:
    - BLOCKER: order sheet's 'sub-millimetre solder bridges' for the two
    remaining unconnected pads misread the DRC track-LENGTH field as a
    gap. Re-measured from the board file: U4.1->U4.18 is 3.9mm, U1.48->
    C20.2 is 7.4mm. Remediation rewritten as wire jumpers with routes,
    wire spec, and honest time budget; misread acknowledged in place.
    - HIGH: C24.1 removed from the mandatory via-in-pad remark (reviewer
    re-derivation with exact roundrect geometry: nearest via clears by
    0.153mm; false positive). C2.1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
    [bench_board.kicad_pcb, bench_board.kicad_sch, bom_from_schematic.csv, bom_jlcpcb.csv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]
2026-08-18 kicad-happy pre-order review: order as-is; one BOM-value recommendation (crystal load caps)
    Full toolchain run (schematic/PCB/cross/EMC/SPICE/thermal/gerber) at
    8278577. No order blockers. New finding: Y1 C115962 is a 20pF-load
    crystal against 10pF C17/C18 (effective ~8pF) -- works, ~+200-350ppm,
    inside USB tolerance; recommended free fix is BOM value 33pF before
    upload. Triaged false positives with raw-file proof, most notably the
    analyzer's claim that the batch-6 closed pads are isolated copper
    islands -- point-in-polygon on the real fills shows every closure
    chain landing inside its plane. analysis/ outputs left untracked
    (regenerable).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
2026-08-18 Datasheet verification: HOLD ORDER -- U2 EN at 16.8V vs 6V abs-max; C20 wrong 3 ways; pinouts 100% clean
    First manufacturer-document pass on the board. Every pin of U1 (64/64
    vs ST's official pin XML + DS8626), U2 (9/9 vs SLVSCD5D Table 1), U4
    (13/13 + RESV unconnected, PS-MPU-6000A), U5 (6/6), U6 (6/6) matches --
    zero swapped pins. But: TPS54336A EN is tied to VBAT_4S in copper
    against a 6V abs-max (datasheet sanctions float/open-drain/divider
    only) -- blocker, fix options ranked in the doc; MPU-6000 charge-pump
    cap C20 is 100nF/16V-to-3V3 where the datasheet requires 2.2nF/50V-to-
    GND (value BOM-fixable, return node is copper); Y1 CL=20pF now
    confirmed from the YXC spec sheet, C17/C18->33p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
2026-08-18 Item 0: guard baseline re-established at HEAD -- 53/2/93 verbatim, board 0a5187c95102
    kicad-cli 10.0.5 confirmed; kicad_safe.py DisableAsserts preamble
    confirmed imported by the headless scripts this batch touches.
2026-08-18 Item 1: EN abs-max violation fixed -- TI Figure-15 UVLO divider, EN never above 2.6V
    THE ARITHMETIC (from SLVSCD5D Eq. 2/3 with the device's own numbers:
    Ip=1.15uA, Ih=3.3uA, VENrising=1.21V, VENfalling=1.17V):
    targets Vstart=12.0V, Vstop=11.0V give R1=180.74k, R2=19.89k exact;
    fitted E96 pair R16=182k (LCSC C11481, Extended -- no Basic exists at
    180k/182k 0402), R17=20k (C25765, Basic). Realized thresholds:
    START (rising) = 1.21*(1+182/20) - 1.15uA*182k = 12.012V (3.003V/cell)
    STOP (falling) = 1.17*(1+182/20) - 4.45uA*182k = 11.007V (2.752V/cell)
    hysteresis 1.005V (datasheet recommends >500mV)
    EN pin voltage (divider + (Ip+Ih)*R1||R2): 1.27V @12V, 1.74V @16.8V,
    2.58V @25.2V -- all f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
    [bench_board.kicad_pcb, bench_board.kicad_sch]
2026-08-18 Item 2: MPU-6000 charge-pump cap fixed on all three axes -- 2.2nF, 50V part, returned to GND
    Per PS-MPU-6000A section 7.3: CPOUT capacitor must be 2.2nF X7R 50V to
    GND; the board had 100nF/16V to 3V3. Schematic: C20 pin-2 label 3V3 ->
    GND, value 100nF -> 2.2nF; ERC 0; netlist verified /MPU_CPOUT =
    {C20.1, U4.20} and C20.2 now in /GND. Part: Yageo CC0402KRX7R9BB222,
    LCSC C106861 (X7R 50V, 1.14M stock) -- no Basic-library 2.2nF/50V 0402
    exists, so this is one more Extended fee, said plainly.
    Board: pad 2 renet to /GND; the two 3V3 feeder segments deleted (C21.1
    keeps its feed from the far side -- verified the chain is fed from
    (44.708,34.932), not through C20); new 0.3mm GND return east-then-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
    [bench_board.kicad_pcb, bench_board.kicad_sch]
2026-08-18 Item 3: crystal load caps C17/C18 10pF -> 33pF (CL=20pF crystal, manufacturer-confirmed)
    Y1 (C115962, YXC X50328MSB2GI) is a 20pF-load crystal per the Yangxing
    spec sheet read in the 2026-08-18 datasheet pass. 33pF gives
    CL = 33/2 + ~3 stray = 19.5pF against the 20pF spec; the previous 10pF
    pair ran the oscillator at ~8pF, ~+200-350ppm fast. Part: FH
    0402CG330J500NT, LCSC C1562, C0G 50V, Basic library, 690k stock -- C0G
    is also the right dielectric for load caps. Value-only change,
    schematic and board together; ERC 0; guard PASS 53/2/95 unchanged.
    C1 confirmed carried: schematic/board value still '10uF 50V X7S 1210'
    (GCM32EC71H106KA03 / C126612 bias-verified resolution intact).
    Co-Authored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
    [bench_board.kicad_pcb, bench_board.kicad_sch]
2026-08-18 Item 4: fab package 2026-08-18a; 17c superseded for the EN abs-max violation
    Fresh gerbers/drill/CPL/BOM/DRC from board e06a699 (53/2/95 verbatim).
    check_cpl PASS 63/63 (checker + falsifiability case re-pointed here).
    BOM: +R16 (C11481, Extended -- no Basic 182k 0402 exists), +R17
    (C25765, Basic), C20 split from the 100nF group to 2.2nF/50V C106861
    (Extended -- no Basic 2.2nF/50V 0402 exists), C17/C18 -> 33pF C1562
    (Basic). 13 Extended numbers, 9 in fees, estimate +.
    ORDER-SHEET carried forward wholesale: filled-and-capped requirement
    unchanged and mandatory (R16 pad 2's EN via ADDED to the pad list);
    both STOP conditions kept; nine hand-soldered headers and Amphenol
    USB-C unchanged; U1.48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
    [bench_board-B_Cu.gbr, bench_board-B_Mask.gbr, bench_board-B_Paste.gbr, bench_board-B_Silkscreen.gbr, bench_board-Edge_Cuts.gbr, bench_board-F_Cu.gbr, bench_board-F_Mask.gbr, bench_board-F_Paste.gbr]
2026-08-18 Batch 7 review fixes: worst-case UVLO honesty, quantified via-in-pad, traceable specs
    Independent review (fresh Opus agent): 0 BLOCKER, 1 HIGH, 4 MEDIUM,
    6 LOW. It reproduced the EN divider arithmetic exactly (including a
    worst-case 1% resistor sweep: EN 2.62V max at 25.2V -- violation
    closed), traced C20's GND return copper to the plane via, verified
    guard hashes hash-for-hash on all board commits, and accounted for
    every copper delta -- zero scope creep. Acted on here:
    - HIGH: the UVLO thresholds were computed from TYPICAL EN-comparator
    values; at datasheet LIMITS start = 12.0-13.0V and stop = 10.1-11.0V
    part-to-part (comparator tolerance dominates the resistors ~6x).
    Order sheet +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
    [bench_board.kicad_sch, bom_jlcpcb.csv]
2026-08-18 CDR: headless FreeCAD tessellation script for the assembly renders
    Dumps stevie-assembly-v0.step to per-solid triangle meshes so the CDR
    deck's assembled and exploded hero images can be shaded from the real
    geometry rather than redrawn. The intermediate mesh JSON is regenerable
    and left untracked.
    Records the freecadcmd trap that cost a debugging round: freecadcmd puts
    the SCRIPT's own path in sys.argv[1], so a script reading argv[1] as its
    input imports itself as CAD geometry and dies with 'no supported file
    format' -- while exiting 0.
